caloangelo/NG-MEDIUM_NX1H35AS_KiCad_repo/PCB_Project.kicad_pcb

## KiCad design PCB_Project.kicad_pcb (2026-10-07)

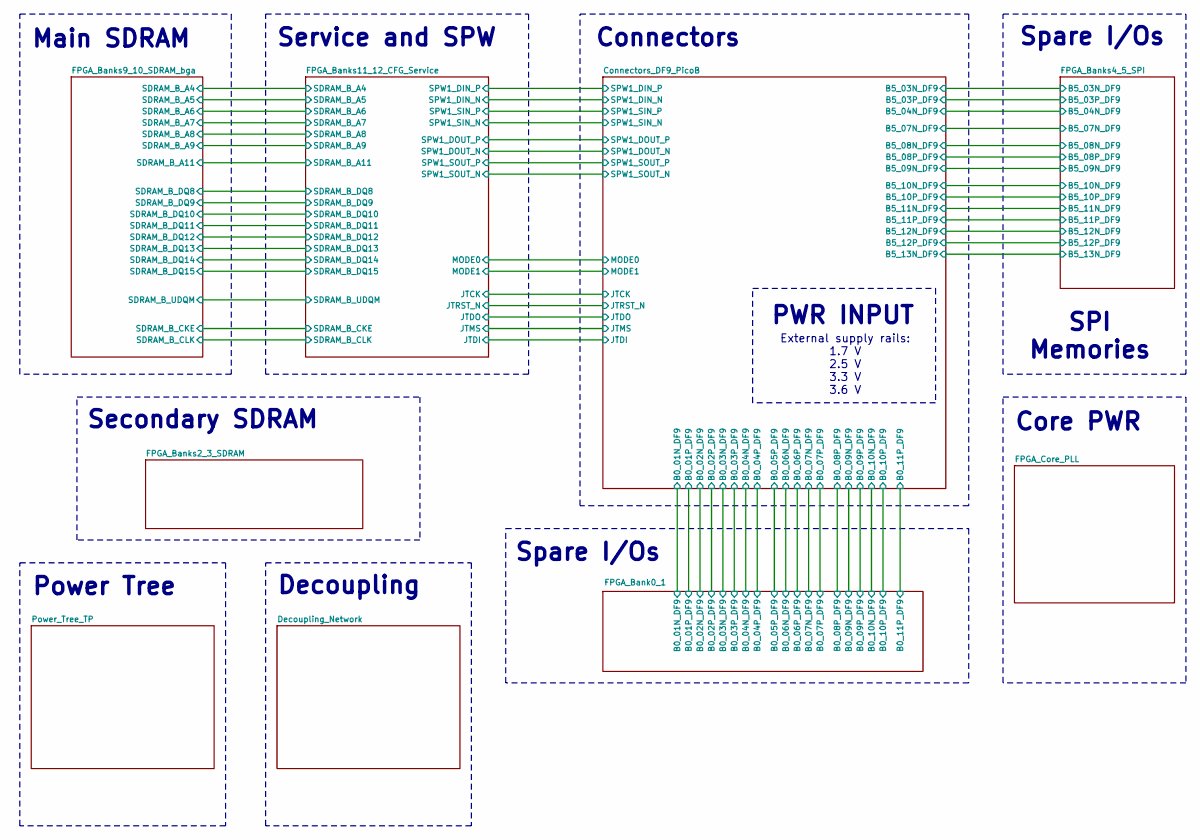
[picture p1: schematic PCB_Project.kicad_sch, DataHub+ Top-Level Schematic]

Notes on the sheet:
Spare I/Os
SPI Memories
Secondary SDRAM
Power Tree
Main SDRAM
Service and SPW
PWR INPUT
Decoupling
External supply rails: 1.7 V 2.5 V 3.3 V 3.6 V
Core PWR
Connectors

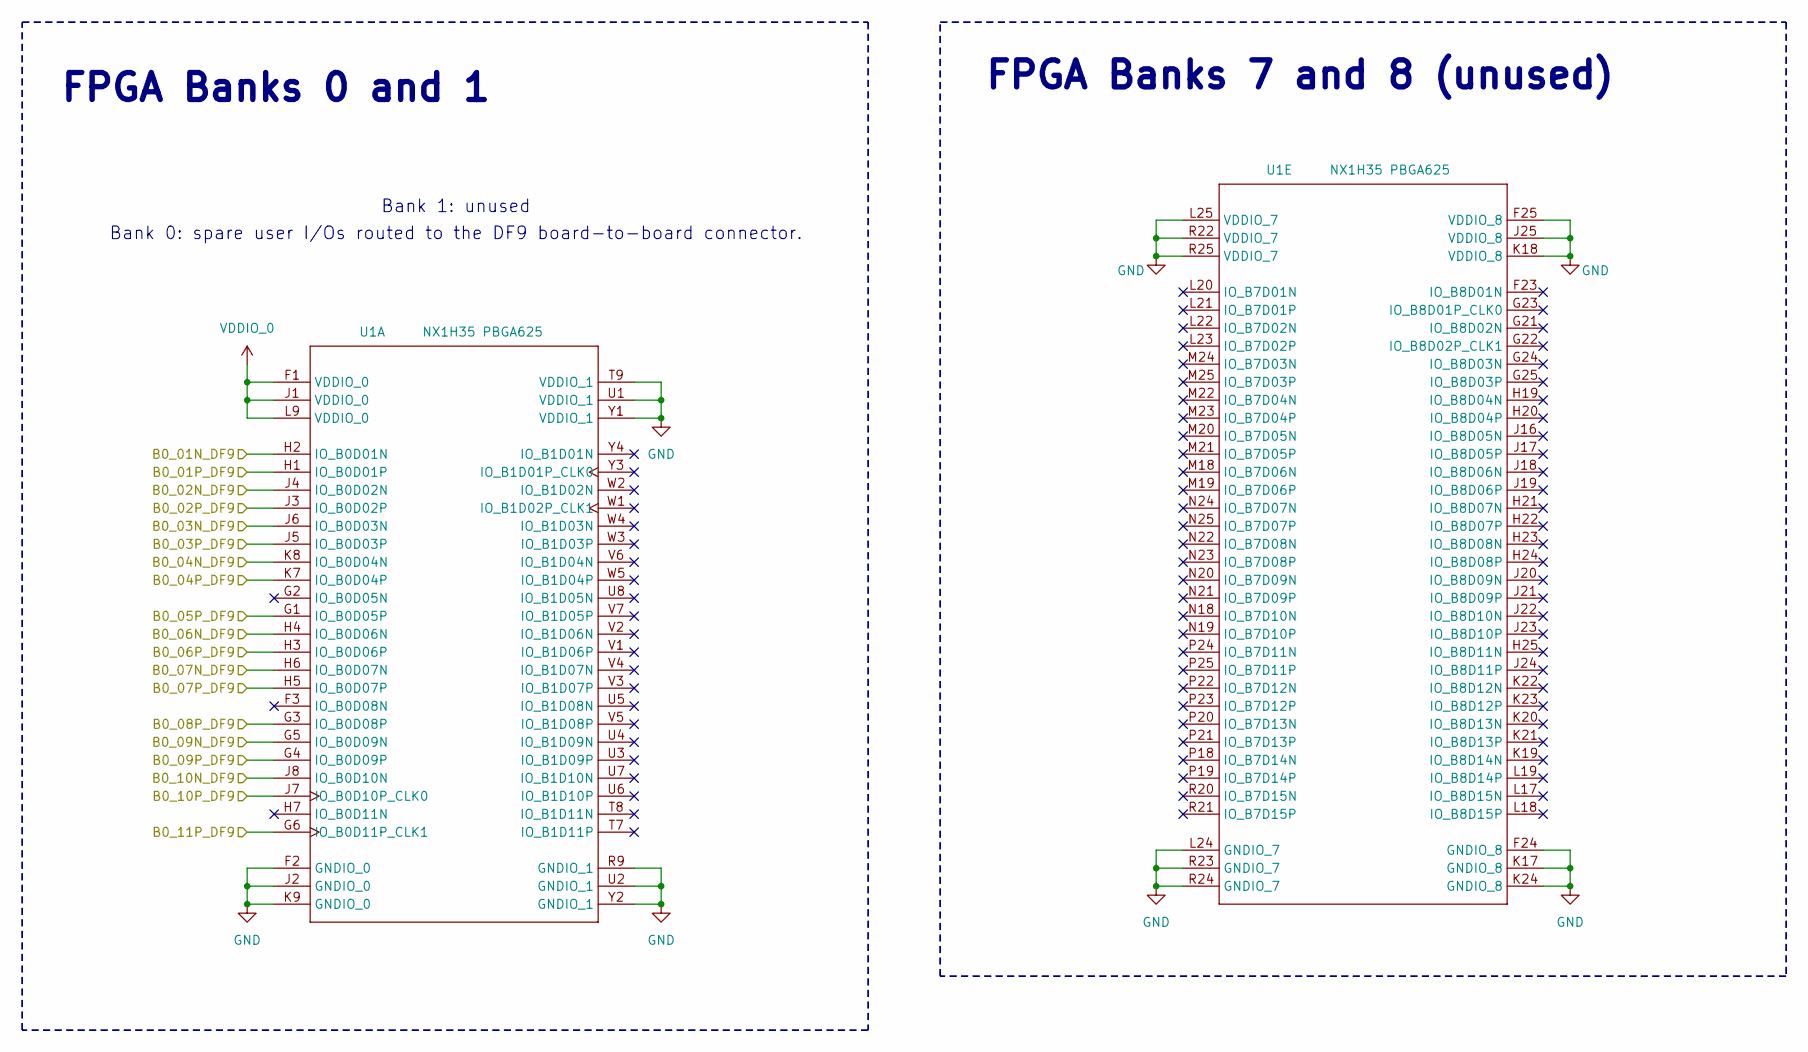
[picture p2: schematic FPGA_Bank0_1.kicad_sch, FPGA Banks 0 and 1]

Parts:
U1: NX1H35 PBGA625; NX1H35S_CLGA625

Connections:
/Connectors_DF9_PicoB/B0_01N_DF9: U1.H2 (IO_B0D01N); also elsewhere on the board
/Connectors_DF9_PicoB/B0_01P_DF9: U1.H1 (IO_B0D01P); also elsewhere on the board
/Connectors_DF9_PicoB/B0_02N_DF9: U1.J4 (IO_B0D02N); also elsewhere on the board
/Connectors_DF9_PicoB/B0_02P_DF9: U1.J3 (IO_B0D02P); also elsewhere on the board
/Connectors_DF9_PicoB/B0_03N_DF9: U1.J6 (IO_B0D03N); also elsewhere on the board
/Connectors_DF9_PicoB/B0_03P_DF9: U1.J5 (IO_B0D03P); also elsewhere on the board
/Connectors_DF9_PicoB/B0_04N_DF9: U1.K8 (IO_B0D04N); also elsewhere on the board
/Connectors_DF9_PicoB/B0_04P_DF9: U1.K7 (IO_B0D04P); also elsewhere on the board
/Connectors_DF9_PicoB/B0_05P_DF9: U1.G1 (IO_B0D05P); also elsewhere on the board
/Connectors_DF9_PicoB/B0_06N_DF9: U1.H4 (IO_B0D06N); also elsewhere on the board
/Connectors_DF9_PicoB/B0_06P_DF9: U1.H3 (IO_B0D06P); also elsewhere on the board
/Connectors_DF9_PicoB/B0_07N_DF9: U1.H6 (IO_B0D07N); also elsewhere on the board
/Connectors_DF9_PicoB/B0_07P_DF9: U1.H5 (IO_B0D07P); also elsewhere on the board
/Connectors_DF9_PicoB/B0_08P_DF9: U1.G3 (IO_B0D08P); also elsewhere on the board
/Connectors_DF9_PicoB/B0_09N_DF9: U1.G5 (IO_B0D09N); also elsewhere on the board
/Connectors_DF9_PicoB/B0_09P_DF9: U1.G4 (IO_B0D09P); also elsewhere on the board
/Connectors_DF9_PicoB/B0_10N_DF9: U1.J8 (IO_B0D10N); also elsewhere on the board
/Connectors_DF9_PicoB/B0_10P_DF9: U1.J7 (IO_B0D10P_CLK0); also elsewhere on the board
/Connectors_DF9_PicoB/B0_11P_DF9: U1.G6 (IO_B0D11P_CLK1); also elsewhere on the board
GND: U1.F2 (GNDIO_0), U1.F24 (GNDIO_8), U1.F25 (VDDIO_8), U1.J2 (GNDIO_0), U1.J25 (VDDIO_8), U1.K9 (GNDIO_0), U1.K17 (GNDIO_8), U1.K18 (VDDIO_8), U1.K24 (GNDIO_8), U1.L24 (GNDIO_7), U1.L25 (VDDIO_7), U1.R9 (GNDIO_1), U1.R22 (VDDIO_7), U1.R23 (GNDIO_7), U1.R24 (GNDIO_7), U1.R25 (VDDIO_7), U1.T9 (VDDIO_1), U1.U1 (VDDIO_1), U1.U2 (GNDIO_1), U1.Y1 (VDDIO_1), U1.Y2 (GNDIO_1); also elsewhere on the board
VDD3V3: U1.F1 (VDDIO_0), U1.J1 (VDDIO_0), U1.L9 (VDDIO_0); also elsewhere on the board

Notes on the sheet:
Bank 0: spare user I/Os routed to the DF9 board-to-board connector.
FPGA Banks 0 and 1
FPGA Banks 7 and 8 (unused)
Bank 1: unused

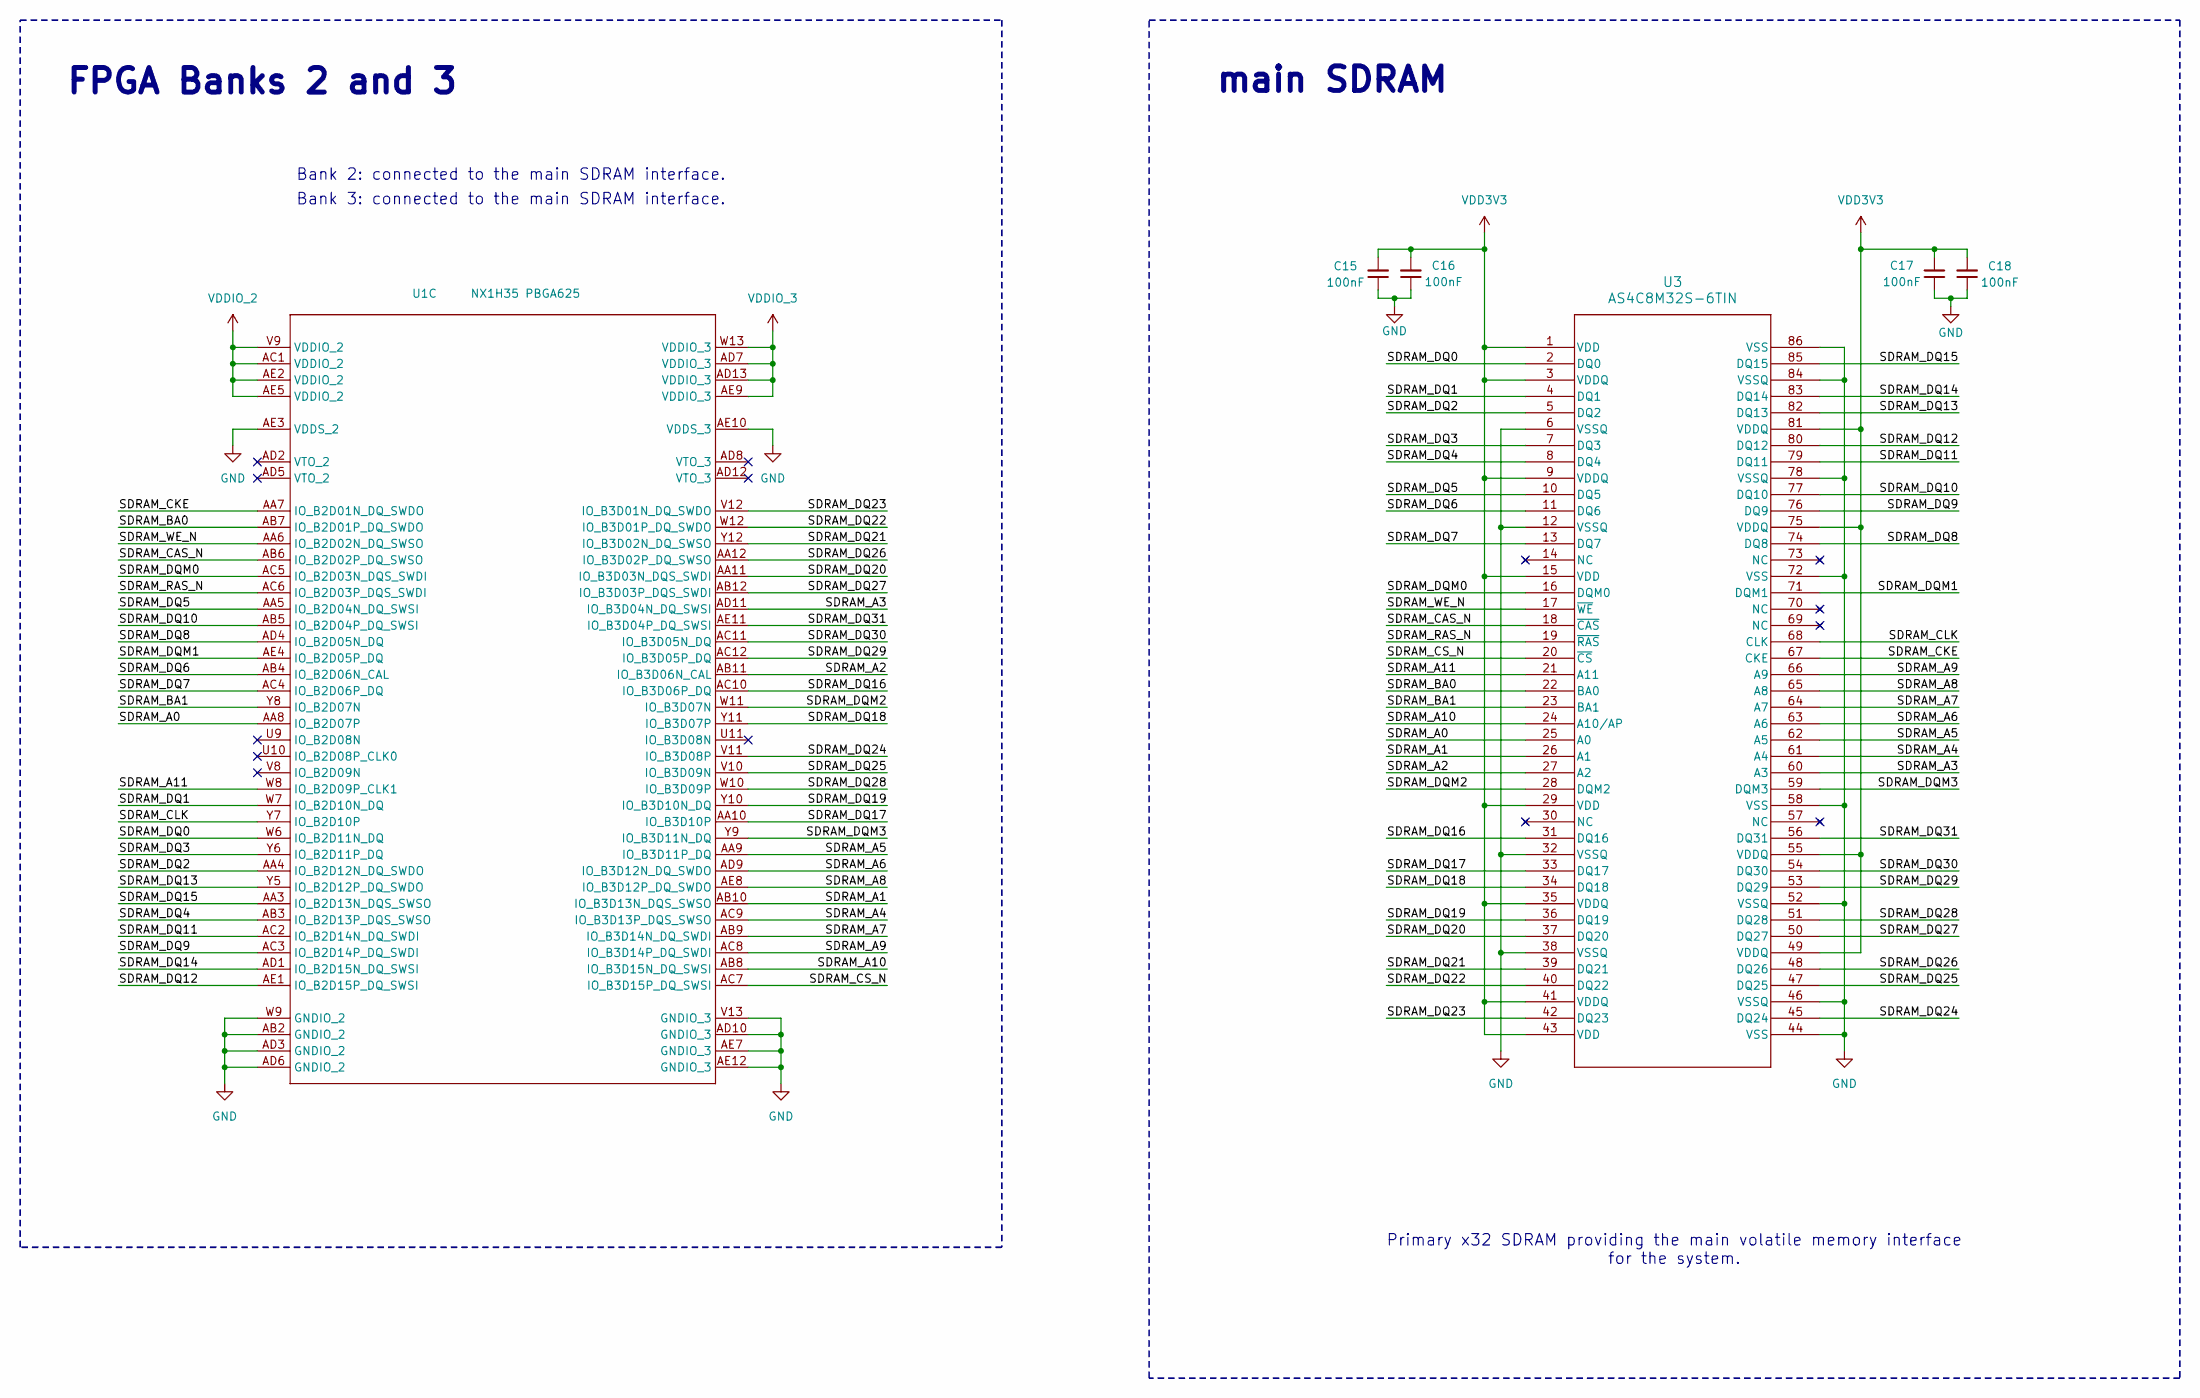
[picture p3: schematic FPGA_Banks2_3_SDRAM.kicad_sch, Primary SDRAM Interface - FPGA Banks 2 and 3]

Parts:
C15, C16, C17, C18: 100nF; C_0402_1005Metric_Pad0.74x0.62mm_HandSolder
U1: NX1H35 PBGA625; NX1H35S_CLGA625
U3: AS4C8M32S-6TIN; AS4C8M32S_TSOP-II-86_ALL

Connections:
/FPGA_Banks2_3_SDRAM/SDRAM_A0: U1.AA8 (IO_B2D07P), U3.25 (A0)
/FPGA_Banks2_3_SDRAM/SDRAM_A1: U1.AB10 (IO_B3D13N_DQS_SWSO), U3.26 (A1)
/FPGA_Banks2_3_SDRAM/SDRAM_A2: U1.AB11 (IO_B3D06N_CAL), U3.27 (A2)
/FPGA_Banks2_3_SDRAM/SDRAM_A3: U1.AD11 (IO_B3D04N_DQ_SWSI), U3.60 (A3)
/FPGA_Banks2_3_SDRAM/SDRAM_A4: U1.AC9 (IO_B3D13P_DQS_SWSO), U3.61 (A4)
/FPGA_Banks2_3_SDRAM/SDRAM_A5: U1.AA9 (IO_B3D11P_DQ), U3.62 (A5)
/FPGA_Banks2_3_SDRAM/SDRAM_A6: U1.AD9 (IO_B3D12N_DQ_SWDO), U3.63 (A6)
/FPGA_Banks2_3_SDRAM/SDRAM_A7: U1.AB9 (IO_B3D14N_DQ_SWDI), U3.64 (A7)
/FPGA_Banks2_3_SDRAM/SDRAM_A8: U1.AE8 (IO_B3D12P_DQ_SWDO), U3.65 (A8)
/FPGA_Banks2_3_SDRAM/SDRAM_A9: U1.AC8 (IO_B3D14P_DQ_SWDI), U3.66 (A9)
/FPGA_Banks2_3_SDRAM/SDRAM_A10: U1.AB8 (IO_B3D15N_DQ_SWSI), U3.24 (A10/AP)
/FPGA_Banks2_3_SDRAM/SDRAM_A11: U1.W8 (IO_B2D09P_CLK1), U3.21 (A11)
/FPGA_Banks2_3_SDRAM/SDRAM_BA0: U1.AB7 (IO_B2D01P_DQ_SWDO), U3.22 (BA0)
/FPGA_Banks2_3_SDRAM/SDRAM_BA1: U1.Y8 (IO_B2D07N), U3.23 (BA1)
/FPGA_Banks2_3_SDRAM/SDRAM_CAS_N: U1.AB6 (IO_B2D02P_DQ_SWSO), U3.18 (~CAS)
/FPGA_Banks2_3_SDRAM/SDRAM_CKE: U1.AA7 (IO_B2D01N_DQ_SWDO), U3.67 (CKE)
/FPGA_Banks2_3_SDRAM/SDRAM_CLK: U1.Y7 (IO_B2D10P), U3.68 (CLK)
/FPGA_Banks2_3_SDRAM/SDRAM_CS_N: U1.AC7 (IO_B3D15P_DQ_SWSI), U3.20 (~CS)
/FPGA_Banks2_3_SDRAM/SDRAM_DQ0: U1.W6 (IO_B2D11N_DQ), U3.2 (DQ0)
/FPGA_Banks2_3_SDRAM/SDRAM_DQ1: U1.W7 (IO_B2D10N_DQ), U3.4 (DQ1)
/FPGA_Banks2_3_SDRAM/SDRAM_DQ2: U1.AA4 (IO_B2D12N_DQ_SWDO), U3.5 (DQ2)
/FPGA_Banks2_3_SDRAM/SDRAM_DQ3: U1.Y6 (IO_B2D11P_DQ), U3.7 (DQ3)
/FPGA_Banks2_3_SDRAM/SDRAM_DQ4: U1.AB3 (IO_B2D13P_DQS_SWSO), U3.8 (DQ4)
/FPGA_Banks2_3_SDRAM/SDRAM_DQ5: U1.AA5 (IO_B2D04N_DQ_SWSI), U3.10 (DQ5)
/FPGA_Banks2_3_SDRAM/SDRAM_DQ6: U1.AB4 (IO_B2D06N_CAL), U3.11 (DQ6)
/FPGA_Banks2_3_SDRAM/SDRAM_DQ7: U1.AC4 (IO_B2D06P_DQ), U3.13 (DQ7)
/FPGA_Banks2_3_SDRAM/SDRAM_DQ8: U1.AD4 (IO_B2D05N_DQ), U3.74 (DQ8)
/FPGA_Banks2_3_SDRAM/SDRAM_DQ9: U1.AC3 (IO_B2D14P_DQ_SWDI), U3.76 (DQ9)
/FPGA_Banks2_3_SDRAM/SDRAM_DQ10: U1.AB5 (IO_B2D04P_DQ_SWSI), U3.77 (DQ10)
/FPGA_Banks2_3_SDRAM/SDRAM_DQ11: U1.AC2 (IO_B2D14N_DQ_SWDI), U3.79 (DQ11)
/FPGA_Banks2_3_SDRAM/SDRAM_DQ12: U1.AE1 (IO_B2D15P_DQ_SWSI), U3.80 (DQ12)
/FPGA_Banks2_3_SDRAM/SDRAM_DQ13: U1.Y5 (IO_B2D12P_DQ_SWDO), U3.82 (DQ13)
/FPGA_Banks2_3_SDRAM/SDRAM_DQ14: U1.AD1 (IO_B2D15N_DQ_SWSI), U3.83 (DQ14)
/FPGA_Banks2_3_SDRAM/SDRAM_DQ15: U1.AA3 (IO_B2D13N_DQS_SWSO), U3.85 (DQ15)
/FPGA_Banks2_3_SDRAM/SDRAM_DQ16: U1.AC10 (IO_B3D06P_DQ), U3.31 (DQ16)
/FPGA_Banks2_3_SDRAM/SDRAM_DQ17: U1.AA10 (IO_B3D10P), U3.33 (DQ17)
/FPGA_Banks2_3_SDRAM/SDRAM_DQ18: U1.Y11 (IO_B3D07P), U3.34 (DQ18)
/FPGA_Banks2_3_SDRAM/SDRAM_DQ19: U1.Y10 (IO_B3D10N_DQ), U3.36 (DQ19)
/FPGA_Banks2_3_SDRAM/SDRAM_DQ20: U1.AA11 (IO_B3D03N_DQS_SWDI), U3.37 (DQ20)
/FPGA_Banks2_3_SDRAM/SDRAM_DQ21: U1.Y12 (IO_B3D02N_DQ_SWSO), U3.39 (DQ21)
/FPGA_Banks2_3_SDRAM/SDRAM_DQ22: U1.W12 (IO_B3D01P_DQ_SWDO), U3.40 (DQ22)
/FPGA_Banks2_3_SDRAM/SDRAM_DQ23: U1.V12 (IO_B3D01N_DQ_SWDO), U3.42 (DQ23)
/FPGA_Banks2_3_SDRAM/SDRAM_DQ24: U1.V11 (IO_B3D08P), U3.45 (DQ24)
/FPGA_Banks2_3_SDRAM/SDRAM_DQ25: U1.V10 (IO_B3D09N), U3.47 (DQ25)
/FPGA_Banks2_3_SDRAM/SDRAM_DQ26: U1.AA12 (IO_B3D02P_DQ_SWSO), U3.48 (DQ26)
/FPGA_Banks2_3_SDRAM/SDRAM_DQ27: U1.AB12 (IO_B3D03P_DQS_SWDI), U3.50 (DQ27)
/FPGA_Banks2_3_SDRAM/SDRAM_DQ28: U1.W10 (IO_B3D09P), U3.51 (DQ28)
/FPGA_Banks2_3_SDRAM/SDRAM_DQ29: U1.AC12 (IO_B3D05P_DQ), U3.53 (DQ29)
/FPGA_Banks2_3_SDRAM/SDRAM_DQ30: U1.AC11 (IO_B3D05N_DQ), U3.54 (DQ30)
/FPGA_Banks2_3_SDRAM/SDRAM_DQ31: U1.AE11 (IO_B3D04P_DQ_SWSI), U3.56 (DQ31)
/FPGA_Banks2_3_SDRAM/SDRAM_DQM0: U1.AC5 (IO_B2D03N_DQS_SWDI), U3.16 (DQM0)
/FPGA_Banks2_3_SDRAM/SDRAM_DQM1: U1.AE4 (IO_B2D05P_DQ), U3.71 (DQM1)
/FPGA_Banks2_3_SDRAM/SDRAM_DQM2: U1.W11 (IO_B3D07N), U3.28 (DQM2)
/FPGA_Banks2_3_SDRAM/SDRAM_DQM3: U1.Y9 (IO_B3D11N_DQ), U3.59 (DQM3)
/FPGA_Banks2_3_SDRAM/SDRAM_RAS_N: U1.AC6 (IO_B2D03P_DQS_SWDI), U3.19 (~RAS)
/FPGA_Banks2_3_SDRAM/SDRAM_WE_N: U1.AA6 (IO_B2D02N_DQ_SWSO), U3.17 (~WE)
GND: C15.1, C16.1, C17.1, C18.1, U1.AB2 (GNDIO_2), U1.AD3 (GNDIO_2), U1.AD6 (GNDIO_2), U1.AD10 (GNDIO_3), U1.AE3 (VDDS_2), U1.AE7 (GNDIO_3), U1.AE10 (VDDS_3), U1.AE12 (GNDIO_3), U1.V13 (GNDIO_3), U1.W9 (GNDIO_2), U3.6 (VSSQ), U3.12 (VSSQ), U3.32 (VSSQ), U3.38 (VSSQ), U3.44 (VSS), U3.46 (VSSQ), U3.52 (VSSQ), U3.58 (VSS), U3.72 (VSS), U3.78 (VSSQ), U3.84 (VSSQ), U3.86 (VSS); also elsewhere on the board
VDD3V3: C15.2, C16.2, C17.2, C18.2, U1.AC1 (VDDIO_2), U1.AD7 (VDDIO_3), U1.AD13 (VDDIO_3), U1.AE2 (VDDIO_2), U1.AE5 (VDDIO_2), U1.AE9 (VDDIO_3), U1.V9 (VDDIO_2), U1.W13 (VDDIO_3), U3.1 (VDD), U3.3 (VDDQ), U3.9 (VDDQ), U3.15 (VDD), U3.29 (VDD), U3.35 (VDDQ), U3.41 (VDDQ), U3.43 (VDD), U3.49 (VDDQ), U3.55 (VDDQ), U3.75 (VDDQ), U3.81 (VDDQ); also elsewhere on the board

Notes on the sheet:
Bank 3: connected to the main SDRAM interface.
main SDRAM
FPGA Banks 2 and 3
Primary x32 SDRAM providing the main volatile memory interface for the system.
Bank 2: connected to the main SDRAM interface.

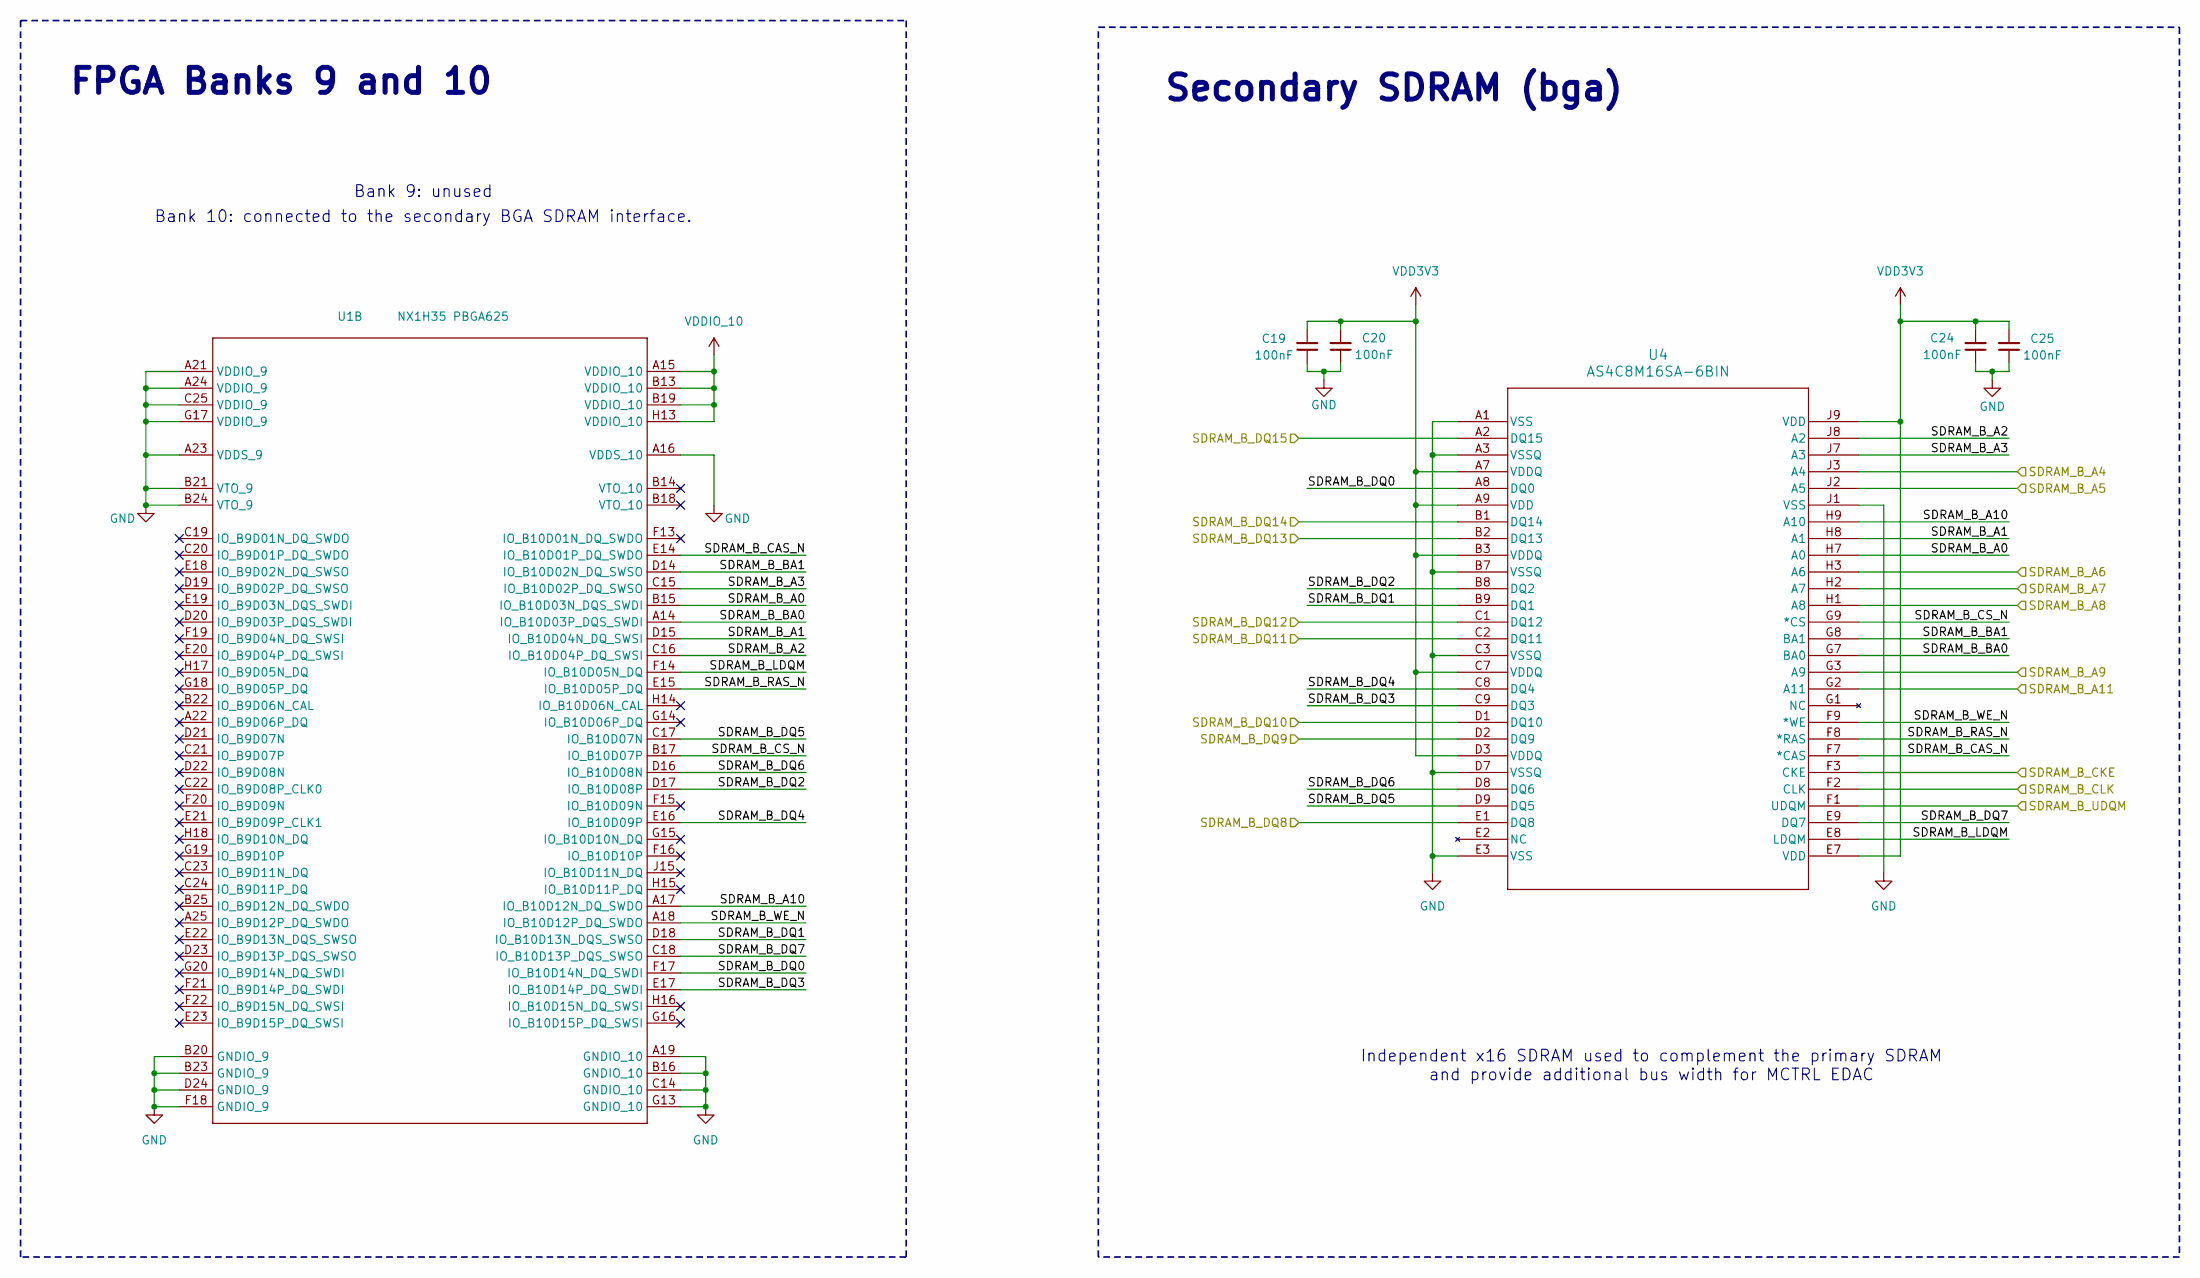
[picture p4: schematic FPGA_Banks9_10_SDRAM_bga.kicad_sch, Secondary SDRAM Interface - FPGA Banks 9 and 10]

Parts:
C19, C20, C24, C25: 100nF; C_0402_1005Metric_Pad0.74x0.62mm_HandSolder
U1: NX1H35 PBGA625; NX1H35S_CLGA625
U4: AS4C8M16SA-6BIN; sdram2_bga_TFBGA-54_8X8_ALL

Connections:
/FPGA_Banks9_10_SDRAM_bga/SDRAM_B_A0: U1.B15 (IO_B10D03N_DQS_SWDI), U4.H7 (A0)
/FPGA_Banks9_10_SDRAM_bga/SDRAM_B_A1: U1.D15 (IO_B10D04N_DQ_SWSI), U4.H8 (A1)
/FPGA_Banks9_10_SDRAM_bga/SDRAM_B_A2: U1.C16 (IO_B10D04P_DQ_SWSI), U4.J8 (A2)
/FPGA_Banks9_10_SDRAM_bga/SDRAM_B_A3: U1.C15 (IO_B10D02P_DQ_SWSO), U4.J7 (A3)
/FPGA_Banks9_10_SDRAM_bga/SDRAM_B_A10: U1.A17 (IO_B10D12N_DQ_SWDO), U4.H9 (A10)
/FPGA_Banks9_10_SDRAM_bga/SDRAM_B_BA0: U1.A14 (IO_B10D03P_DQS_SWDI), U4.G7 (BA0)
/FPGA_Banks9_10_SDRAM_bga/SDRAM_B_BA1: U1.D14 (IO_B10D02N_DQ_SWSO), U4.G8 (BA1)
/FPGA_Banks9_10_SDRAM_bga/SDRAM_B_CAS_N: U1.E14 (IO_B10D01P_DQ_SWDO), U4.F7 (*CAS)
/FPGA_Banks9_10_SDRAM_bga/SDRAM_B_CS_N: U1.B17 (IO_B10D07P), U4.G9 (*CS)
/FPGA_Banks9_10_SDRAM_bga/SDRAM_B_DQ0: U1.F17 (IO_B10D14N_DQ_SWDI), U4.A8 (DQ0)
/FPGA_Banks9_10_SDRAM_bga/SDRAM_B_DQ1: U1.D18 (IO_B10D13N_DQS_SWSO), U4.B9 (DQ1)
/FPGA_Banks9_10_SDRAM_bga/SDRAM_B_DQ2: U1.D17 (IO_B10D08P), U4.B8 (DQ2)
/FPGA_Banks9_10_SDRAM_bga/SDRAM_B_DQ3: U1.E17 (IO_B10D14P_DQ_SWDI), U4.C9 (DQ3)
/FPGA_Banks9_10_SDRAM_bga/SDRAM_B_DQ4: U1.E16 (IO_B10D09P), U4.C8 (DQ4)
/FPGA_Banks9_10_SDRAM_bga/SDRAM_B_DQ5: U1.C17 (IO_B10D07N), U4.D9 (DQ5)
/FPGA_Banks9_10_SDRAM_bga/SDRAM_B_DQ6: U1.D16 (IO_B10D08N), U4.D8 (DQ6)
/FPGA_Banks9_10_SDRAM_bga/SDRAM_B_DQ7: U1.C18 (IO_B10D13P_DQS_SWSO), U4.E9 (DQ7)
/FPGA_Banks9_10_SDRAM_bga/SDRAM_B_LDQM: U1.F14 (IO_B10D05N_DQ), U4.E8 (LDQM)
/FPGA_Banks9_10_SDRAM_bga/SDRAM_B_RAS_N: U1.E15 (IO_B10D05P_DQ), U4.F8 (*RAS)
/FPGA_Banks9_10_SDRAM_bga/SDRAM_B_WE_N: U1.A18 (IO_B10D12P_DQ_SWDO), U4.F9 (*WE)
/FPGA_Banks11_12_CFG_Service/SDRAM_B_A4: U4.J3 (A4); also elsewhere on the board
/FPGA_Banks11_12_CFG_Service/SDRAM_B_A5: U4.J2 (A5); also elsewhere on the board
/FPGA_Banks11_12_CFG_Service/SDRAM_B_A6: U4.H3 (A6); also elsewhere on the board
/FPGA_Banks11_12_CFG_Service/SDRAM_B_A7: U4.H2 (A7); also elsewhere on the board
/FPGA_Banks11_12_CFG_Service/SDRAM_B_A8: U4.H1 (A8); also elsewhere on the board
/FPGA_Banks11_12_CFG_Service/SDRAM_B_A9: U4.G3 (A9); also elsewhere on the board
/FPGA_Banks11_12_CFG_Service/SDRAM_B_A11: U4.G2 (A11); also elsewhere on the board
/FPGA_Banks11_12_CFG_Service/SDRAM_B_CKE: U4.F3 (CKE); also elsewhere on the board
/FPGA_Banks11_12_CFG_Service/SDRAM_B_CLK: U4.F2 (CLK); also elsewhere on the board
/FPGA_Banks11_12_CFG_Service/SDRAM_B_DQ8: U4.E1 (DQ8); also elsewhere on the board
/FPGA_Banks11_12_CFG_Service/SDRAM_B_DQ9: U4.D2 (DQ9); also elsewhere on the board
/FPGA_Banks11_12_CFG_Service/SDRAM_B_DQ10: U4.D1 (DQ10); also elsewhere on the board
/FPGA_Banks11_12_CFG_Service/SDRAM_B_DQ11: U4.C2 (DQ11); also elsewhere on the board
/FPGA_Banks11_12_CFG_Service/SDRAM_B_DQ12: U4.C1 (DQ12); also elsewhere on the board
/FPGA_Banks11_12_CFG_Service/SDRAM_B_DQ13: U4.B2 (DQ13); also elsewhere on the board
/FPGA_Banks11_12_CFG_Service/SDRAM_B_DQ14: U4.B1 (DQ14); also elsewhere on the board
/FPGA_Banks11_12_CFG_Service/SDRAM_B_DQ15: U4.A2 (DQ15); also elsewhere on the board
/FPGA_Banks11_12_CFG_Service/SDRAM_B_UDQM: U4.F1 (UDQM); also elsewhere on the board
GND: C19.1, C20.1, C24.1, C25.1, U1.A16 (VDDS_10), U1.A19 (GNDIO_10), U1.A21 (VDDIO_9), U1.A23 (VDDS_9), U1.A24 (VDDIO_9), U1.B16 (GNDIO_10), U1.B20 (GNDIO_9), U1.B21 (VTO_9), U1.B23 (GNDIO_9), U1.B24 (VTO_9), U1.C14 (GNDIO_10), U1.C25 (VDDIO_9), U1.D24 (GNDIO_9), U1.F18 (GNDIO_9), U1.G13 (GNDIO_10), U1.G17 (VDDIO_9), U4.A1 (VSS), U4.A3 (VSSQ), U4.B7 (VSSQ), U4.C3 (VSSQ), U4.D7 (VSSQ), U4.E3 (VSS), U4.J1 (VSS); also elsewhere on the board
VDD3V3: C19.2, C20.2, C24.2, C25.2, U1.A15 (VDDIO_10), U1.B13 (VDDIO_10), U1.B19 (VDDIO_10), U1.H13 (VDDIO_10), U4.A7 (VDDQ), U4.A9 (VDD), U4.B3 (VDDQ), U4.C7 (VDDQ), U4.D3 (VDDQ), U4.E7 (VDD), U4.J9 (VDD); also elsewhere on the board

Notes on the sheet:
Bank 9: unused
FPGA Banks 9 and 10
Secondary SDRAM (bga)
Independent x16 SDRAM used to complement the primary SDRAM and provide additional bus width for MCTRL EDAC
Bank 10: connected to the secondary BGA SDRAM interface.

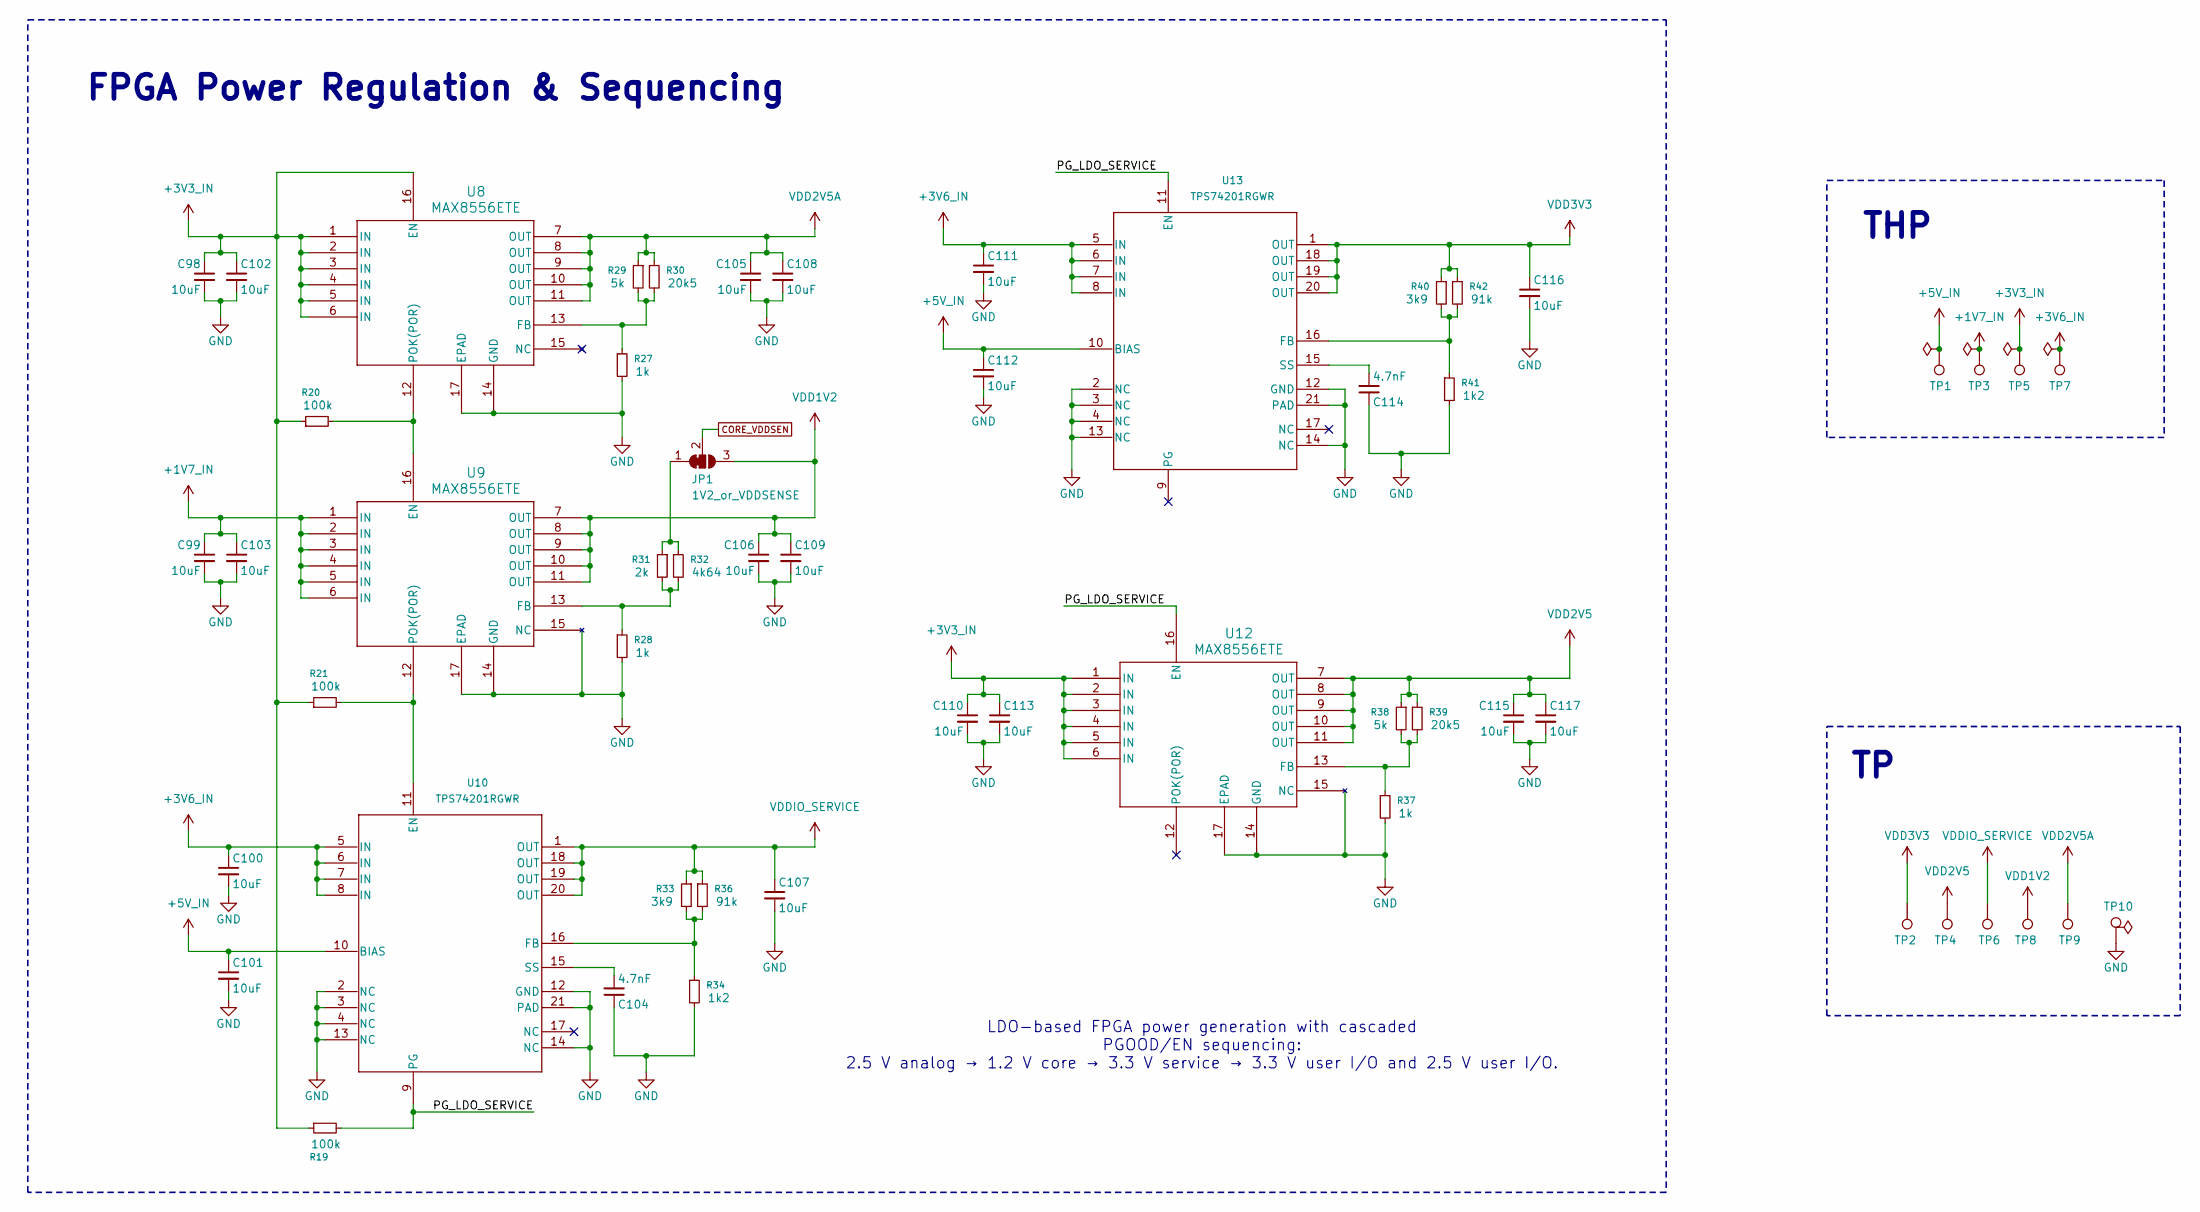
[picture p5: schematic Power_Tree_TP.kicad_sch, Power Tree and Test Points]

Parts:
C98, C99, C100, C101, C102, C103, C105, C106, C107, C108, C109, C110, C111, C112, C113, C115, C116, C117: 10uF; C_0603_1608Metric_Pad1.08x0.95mm_HandSolder
C104, C114: 4.7nF; C_0402_1005Metric_Pad0.74x0.62mm_HandSolder
JP1: 1V2_or_VDDSENSE; SolderJumper-3_P1.3mm_Bridged2Bar12_RoundedPad1.0x1.5mm
R19, R20, R21: 100k; R_0402_1005Metric_Pad0.72x0.64mm_HandSolder
R27, R28, R37: 1k; R_0402_1005Metric_Pad0.72x0.64mm_HandSolder
R29, R38: 5k; R_0402_1005Metric_Pad0.72x0.64mm_HandSolder
R30, R39: 20k5; R_0402_1005Metric_Pad0.72x0.64mm_HandSolder
R31: 2k; R_0402_1005Metric_Pad0.72x0.64mm_HandSolder
R32: 4k64; R_0402_1005Metric_Pad0.72x0.64mm_HandSolder
R33, R40: 3k9; R_0402_1005Metric_Pad0.72x0.64mm_HandSolder
R34, R41: 1k2; R_0402_1005Metric_Pad0.72x0.64mm_HandSolder
R36, R42: 91k; R_0402_1005Metric_Pad0.72x0.64mm_HandSolder
TP1: 5V; PTH_pad_2x0.8
TP2, TP6: 3V3; Test_Point
TP3: 1V7; PTH_pad_2x0.8
TP4: 2V5; Test_Point
TP5: 3V3; PTH_pad_2x0.8
TP7: 3V6; PTH_pad_2x0.8
TP8: 1V2; Test_Point
TP9: 2V5A; Test_Point
TP10: GND; Test_Point
U8, U9, U12: MAX8556ETE; MAX8556
U10, U13: TPS74201RGWR; TPS74201

Connections:
+1V7_IN: C99.1, C103.1, TP3.1, U9.1 (IN), U9.2 (IN), U9.3 (IN), U9.4 (IN), U9.5 (IN), U9.6 (IN); also elsewhere on the board
+3V3_IN: C98.1, C102.1, C110.1, C113.1, R19.1, R20.1, R21.1, TP5.1, U8.1 (IN), U8.2 (IN), U8.3 (IN), U8.4 (IN), U8.5 (IN), U8.6 (IN), U8.16 (EN), U12.1 (IN), U12.2 (IN), U12.3 (IN), U12.4 (IN), U12.5 (IN), U12.6 (IN); also elsewhere on the board
+3V6_IN: C100.1, C111.1, TP7.1, U10.5 (IN), U10.6 (IN), U10.7 (IN), U10.8 (IN), U13.5 (IN), U13.6 (IN), U13.7 (IN), U13.8 (IN); also elsewhere on the board
+5V_IN: C101.1, C112.1, TP1.1, U10.10 (BIAS), U13.10 (BIAS); also elsewhere on the board
/Power_Tree_TP/PG_LDO_SERVICE: R19.2, U10.9 (PG), U12.16 (EN), U13.11 (EN)
CORE_VDDSEN: JP1.2 (C); also elsewhere on the board
GND: C98.2, C99.2, C100.2, C101.2, C102.2, C103.2, C104.1, C105.2, C106.2, C107.2, C108.2, C109.2, C110.2, C111.2, C112.2, C113.2, C114.1, C115.2, C116.2, C117.2, R27.2, R28.2, R34.2, R37.2, R41.2, TP10.1, U8.14 (GND), U8.17 (EPAD), U9.14 (GND), U9.15 (NC), U9.17 (EPAD), U10.2 (NC), U10.3 (NC), U10.4 (NC), U10.12 (GND), U10.13 (NC), U10.14 (NC), U10.21 (PAD), U12.14 (GND), U12.15 (NC), U12.17 (EPAD), U13.2 (NC), U13.3 (NC), U13.4 (NC), U13.12 (GND), U13.13 (NC), U13.14 (NC), U13.21 (PAD); also elsewhere on the board
unnamed: JP1.1 (A), R31.1, R32.1
unnamed: R27.1, R29.2, R30.2, U8.13 (FB)
unnamed: R20.2, U8.12 (POK(POR)), U9.16 (EN)
unnamed: R28.1, R31.2, R32.2, U9.13 (FB)
unnamed: R21.2, U9.12 (POK(POR)), U10.11 (EN)
unnamed: R33.2, R34.1, R36.2, U10.16 (FB)
unnamed: C104.2, U10.15 (SS)
unnamed: R37.1, R38.2, R39.2, U12.13 (FB)
unnamed: R40.2, R41.1, R42.2, U13.16 (FB)
unnamed: C114.2, U13.15 (SS)
VDD1V2: C106.1, C109.1, JP1.3 (B), TP8.1, U9.7 (OUT), U9.8 (OUT), U9.9 (OUT), U9.10 (OUT), U9.11 (OUT); also elsewhere on the board
VDD2V5: C115.1, C117.1, R38.1, R39.1, TP4.1, U12.7 (OUT), U12.8 (OUT), U12.9 (OUT), U12.10 (OUT), U12.11 (OUT); also elsewhere on the board
VDD2V5A: C105.1, C108.1, R29.1, R30.1, TP9.1, U8.7 (OUT), U8.8 (OUT), U8.9 (OUT), U8.10 (OUT), U8.11 (OUT); also elsewhere on the board
VDD3V3: C116.1, R40.1, R42.1, TP2.1, U13.1 (OUT), U13.18 (OUT), U13.19 (OUT), U13.20 (OUT); also elsewhere on the board
VDDIO_SERVICE: C107.1, R33.1, R36.1, TP6.1, U10.1 (OUT), U10.18 (OUT), U10.19 (OUT), U10.20 (OUT); also elsewhere on the board

Notes on the sheet:
LDO-based FPGA power generation with cascaded PGOOD/EN sequencing: 2.5 V analog → 1.2 V core → 3.3 V service → 3.3 V user I/O and 2.5 V user I/O.
THP
FPGA Power Regulation & Sequencing
