caloangelo/NG-MEDIUM_NX1H35AS_KiCad_repo/PCB_Project.kicad_pcb

## KiCad design PCB_Project.kicad_pcb (continued)

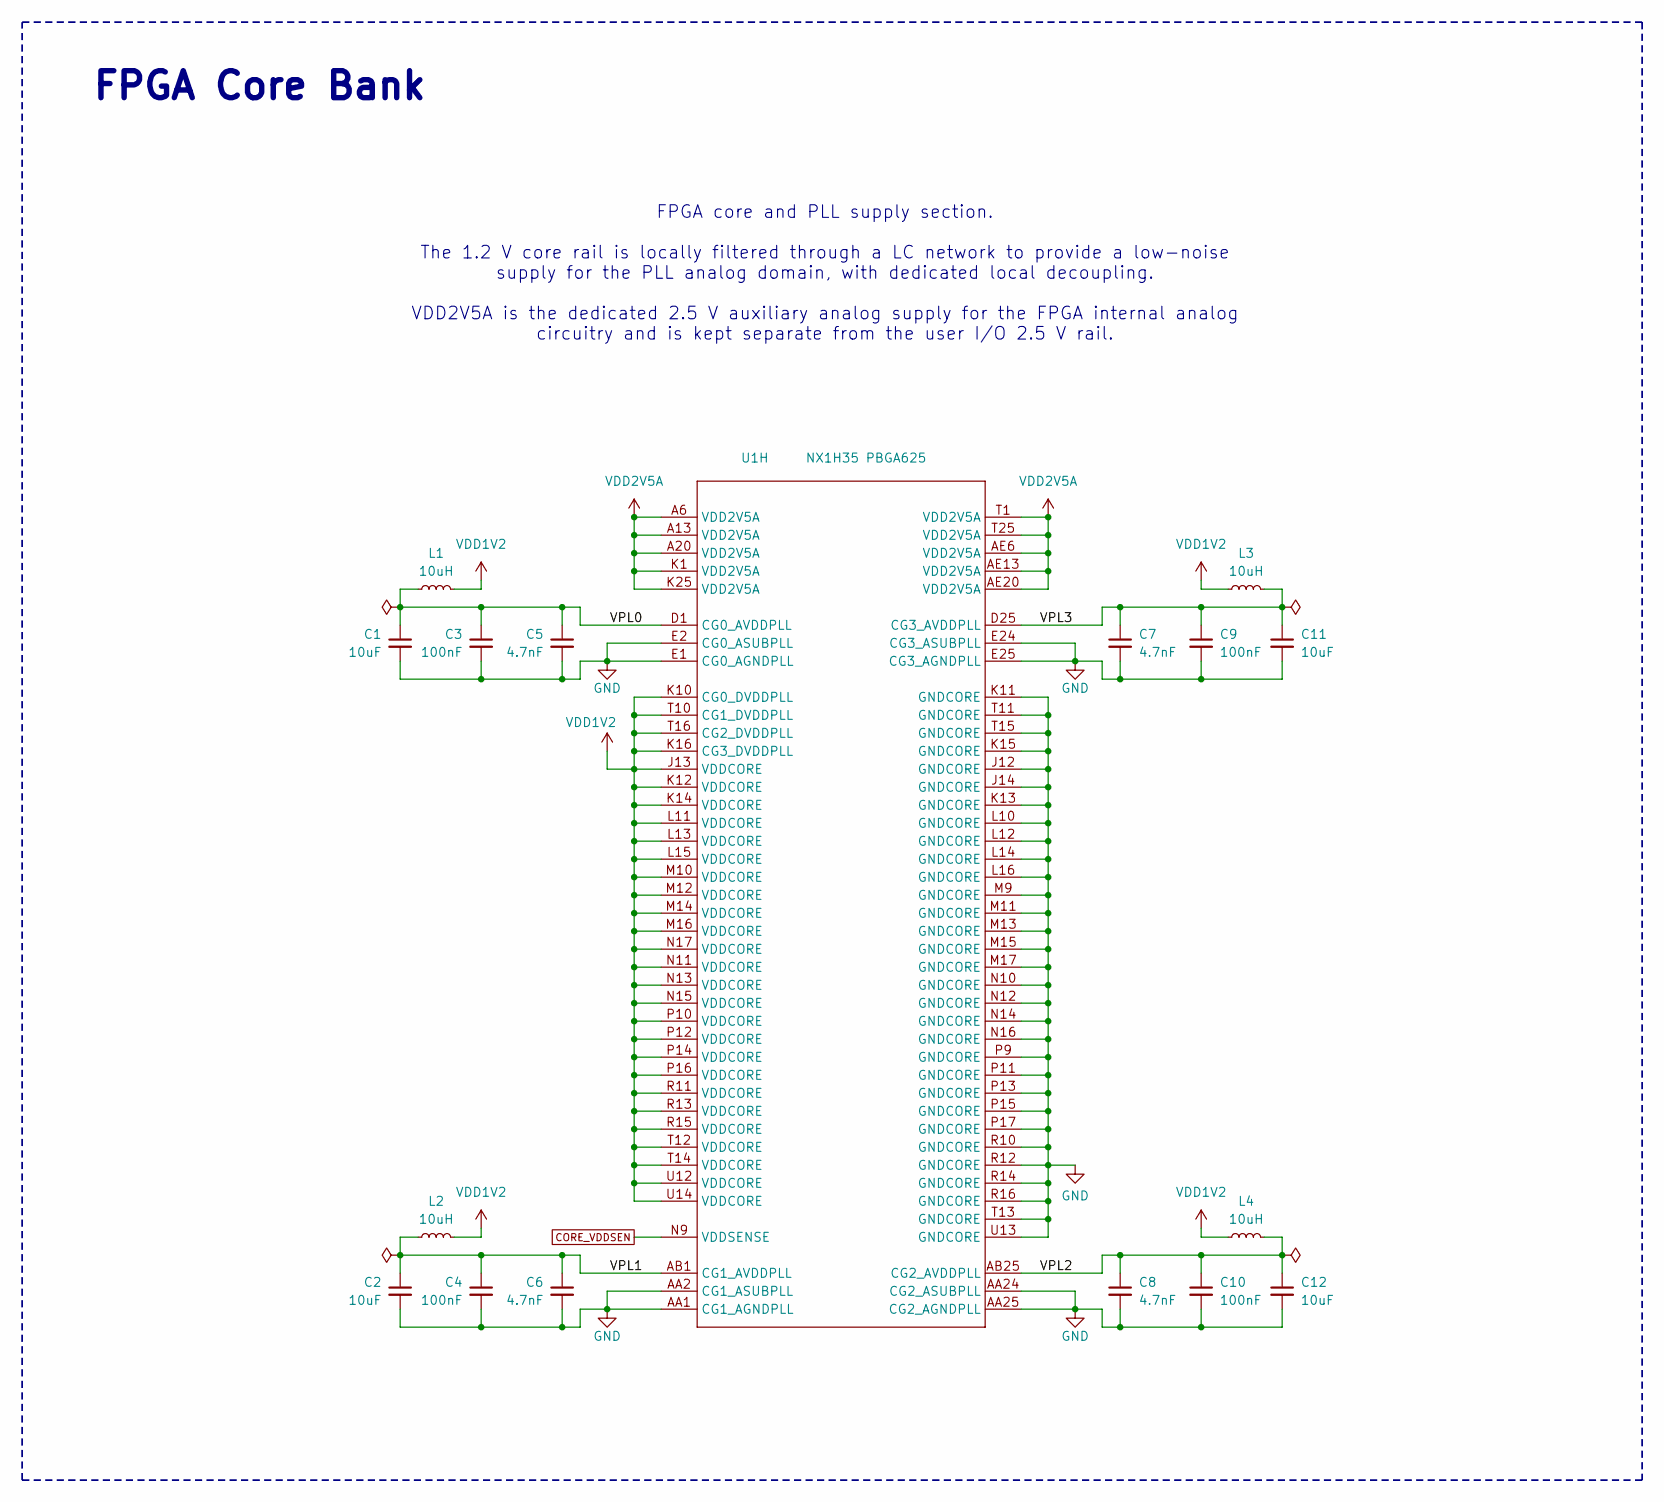
[picture p6: schematic FPGA_Core_PLL.kicad_sch, FPGA Core and PLL Supplies]

Parts:
C1, C2, C11, C12: 10uF; C_0603_1608Metric_Pad1.08x0.95mm_HandSolder
C3, C4, C9, C10: 100nF; C_0402_1005Metric_Pad0.74x0.62mm_HandSolder
C5, C6, C7, C8: 4.7nF; C_0402_1005Metric_Pad0.74x0.62mm_HandSolder
L1, L2, L3, L4: 10uH; L_0603_1608Metric_Pad1.05x0.95mm_HandSolder
U1: NX1H35 PBGA625; NX1H35S_CLGA625

Connections:
/FPGA_Core_PLL/VPL0: C1.1, C3.1, C5.1, L1.2, U1.D1 (CG0_AVDDPLL)
/FPGA_Core_PLL/VPL1: C2.1, C4.1, C6.1, L2.2, U1.AB1 (CG1_AVDDPLL)
/FPGA_Core_PLL/VPL2: C8.1, C10.1, C12.1, L4.2, U1.AB25 (CG2_AVDDPLL)
/FPGA_Core_PLL/VPL3: C7.1, C9.1, C11.1, L3.2, U1.D25 (CG3_AVDDPLL)
CORE_VDDSEN: U1.N9 (VDDSENSE); also elsewhere on the board
GND: C1.2, C2.2, C3.2, C4.2, C5.2, C6.2, C7.2, C8.2, C9.2, C10.2, C11.2, C12.2, U1.AA1 (CG1_AGNDPLL), U1.AA2 (CG1_ASUBPLL), U1.AA24 (CG2_ASUBPLL), U1.AA25 (CG2_AGNDPLL), U1.E1 (CG0_AGNDPLL), U1.E2 (CG0_ASUBPLL), U1.E24 (CG3_ASUBPLL), U1.E25 (CG3_AGNDPLL), U1.J12 (GNDCORE), U1.J14 (GNDCORE), U1.K11 (GNDCORE), U1.K13 (GNDCORE), U1.K15 (GNDCORE), U1.L10 (GNDCORE), U1.L12 (GNDCORE), U1.L14 (GNDCORE), U1.L16 (GNDCORE), U1.M9 (GNDCORE), U1.M11 (GNDCORE), U1.M13 (GNDCORE), U1.M15 (GNDCORE), U1.M17 (GNDCORE), U1.N10 (GNDCORE), U1.N12 (GNDCORE), U1.N14 (GNDCORE), U1.N16 (GNDCORE), U1.P9 (GNDCORE), U1.P11 (GNDCORE), U1.P13 (GNDCORE), U1.P15 (GNDCORE), U1.P17 (GNDCORE), U1.R10 (GNDCORE), U1.R12 (GNDCORE), U1.R14 (GNDCORE), U1.R16 (GNDCORE), U1.T11 (GNDCORE), U1.T13 (GNDCORE), U1.T15 (GNDCORE), U1.U13 (GNDCORE); also elsewhere on the board
VDD1V2: L1.1, L2.1, L3.1, L4.1, U1.J13 (VDDCORE), U1.K10 (CG0_DVDDPLL), U1.K12 (VDDCORE), U1.K14 (VDDCORE), U1.K16 (CG3_DVDDPLL), U1.L11 (VDDCORE), U1.L13 (VDDCORE), U1.L15 (VDDCORE), U1.M10 (VDDCORE), U1.M12 (VDDCORE), U1.M14 (VDDCORE), U1.M16 (VDDCORE), U1.N11 (VDDCORE), U1.N13 (VDDCORE), U1.N15 (VDDCORE), U1.N17 (VDDCORE), U1.P10 (VDDCORE), U1.P12 (VDDCORE), U1.P14 (VDDCORE), U1.P16 (VDDCORE), U1.R11 (VDDCORE), U1.R13 (VDDCORE), U1.R15 (VDDCORE), U1.T10 (CG1_DVDDPLL), U1.T12 (VDDCORE), U1.T14 (VDDCORE), U1.T16 (CG2_DVDDPLL), U1.U12 (VDDCORE), U1.U14 (VDDCORE); also elsewhere on the board
VDD2V5A: U1.A6 (VDD2V5A), U1.A13 (VDD2V5A), U1.A20 (VDD2V5A), U1.AE6 (VDD2V5A), U1.AE13 (VDD2V5A), U1.AE20 (VDD2V5A), U1.K1 (VDD2V5A), U1.K25 (VDD2V5A), U1.T1 (VDD2V5A), U1.T25 (VDD2V5A); also elsewhere on the board

Notes on the sheet:
FPGA Core Bank
FPGA core and PLL supply section. The 1.2 V core rail is locally filtered through a LC network to provide a low-noise supply for the PLL analog domain, with dedicated local decoupling. VDD2V5A is the dedicated 2.5 V auxiliary analog supply for the FPGA internal analog circuitry and is kept separate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

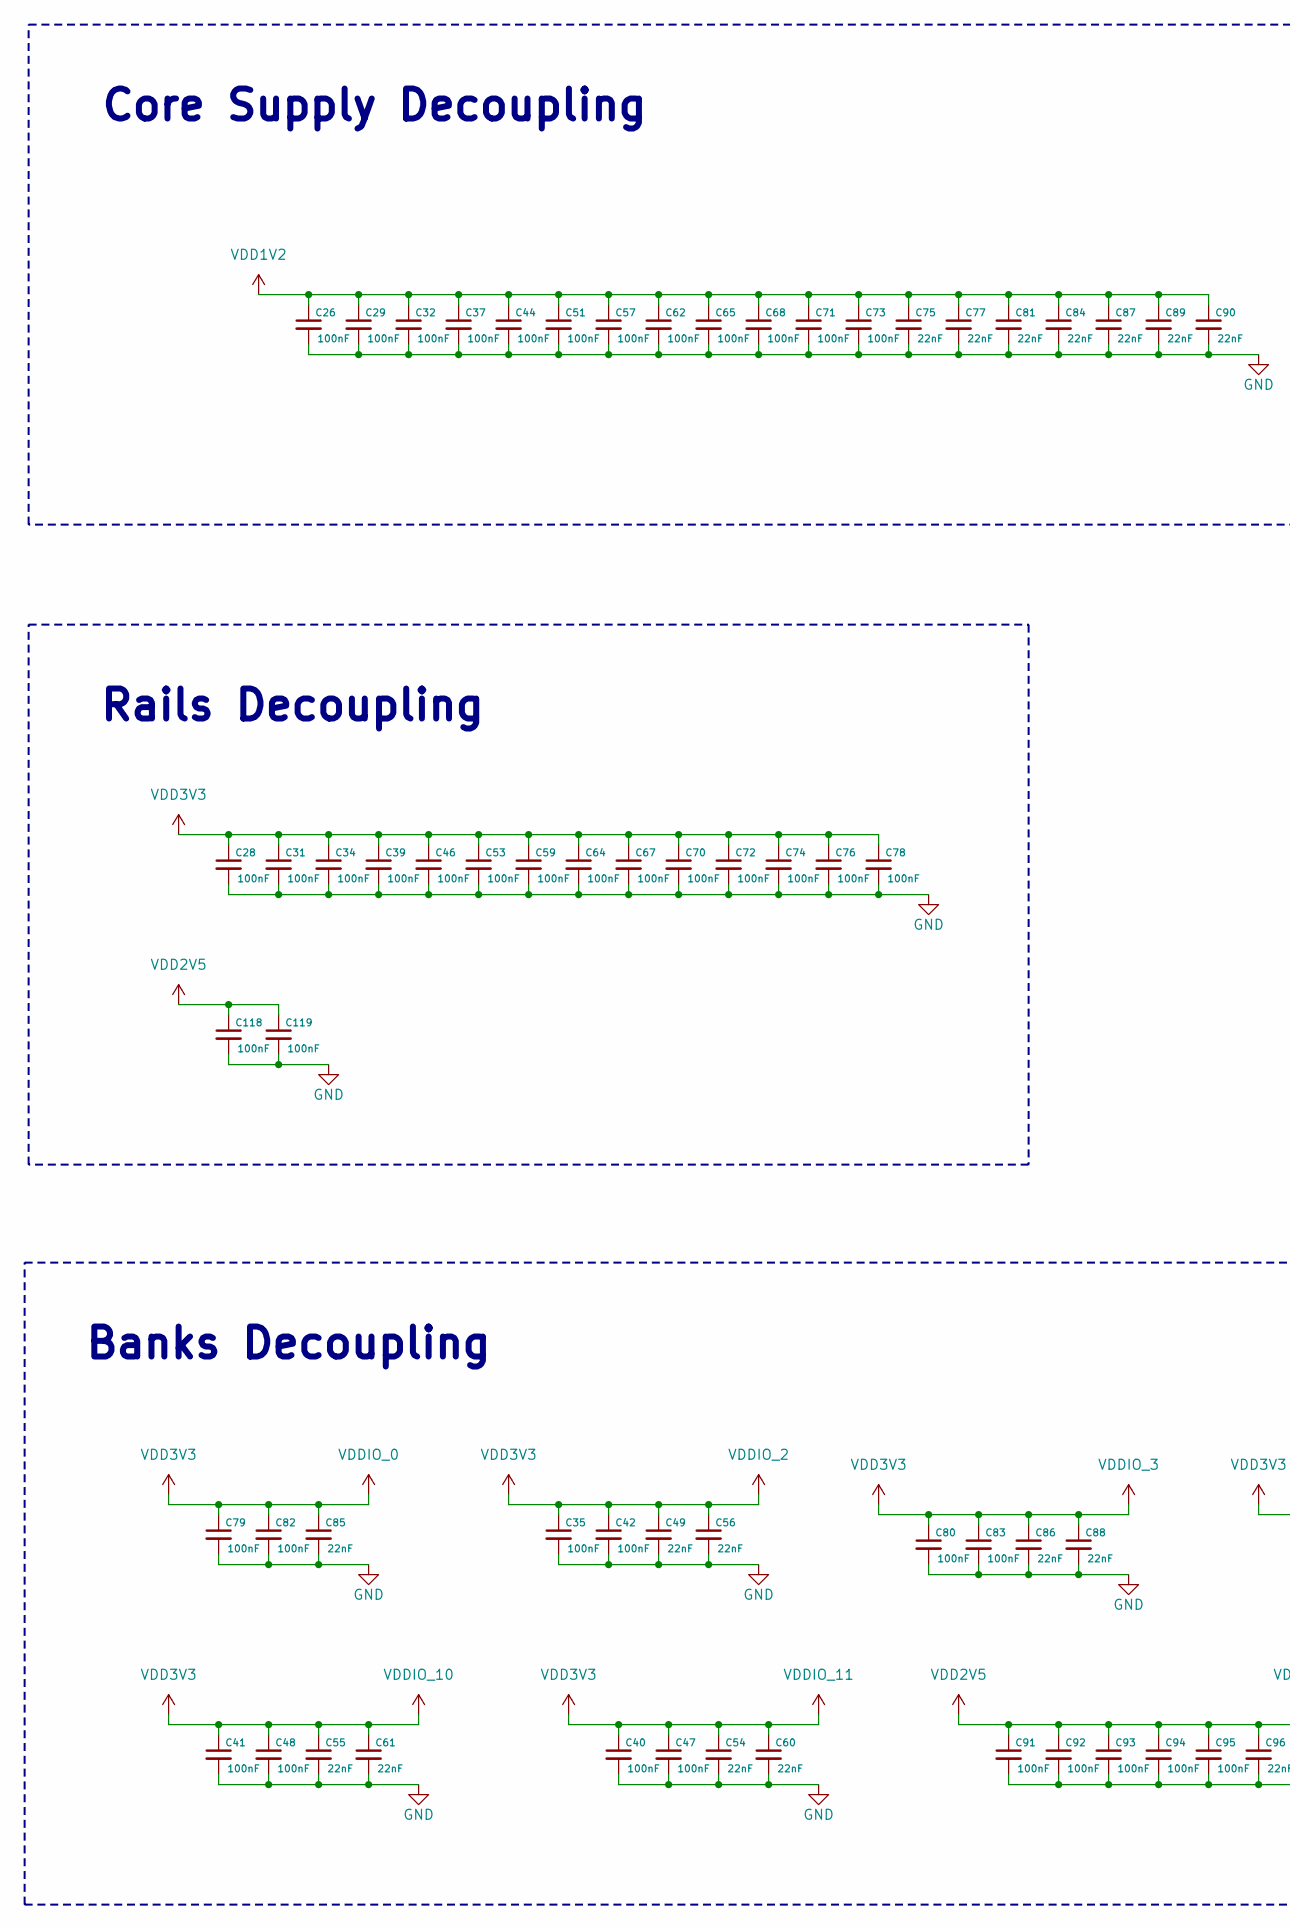
[picture p7: schematic Decoupling_Network.kicad_sch, Power Rails and FPGA Banks Decoupling, part in row 1, column 1]

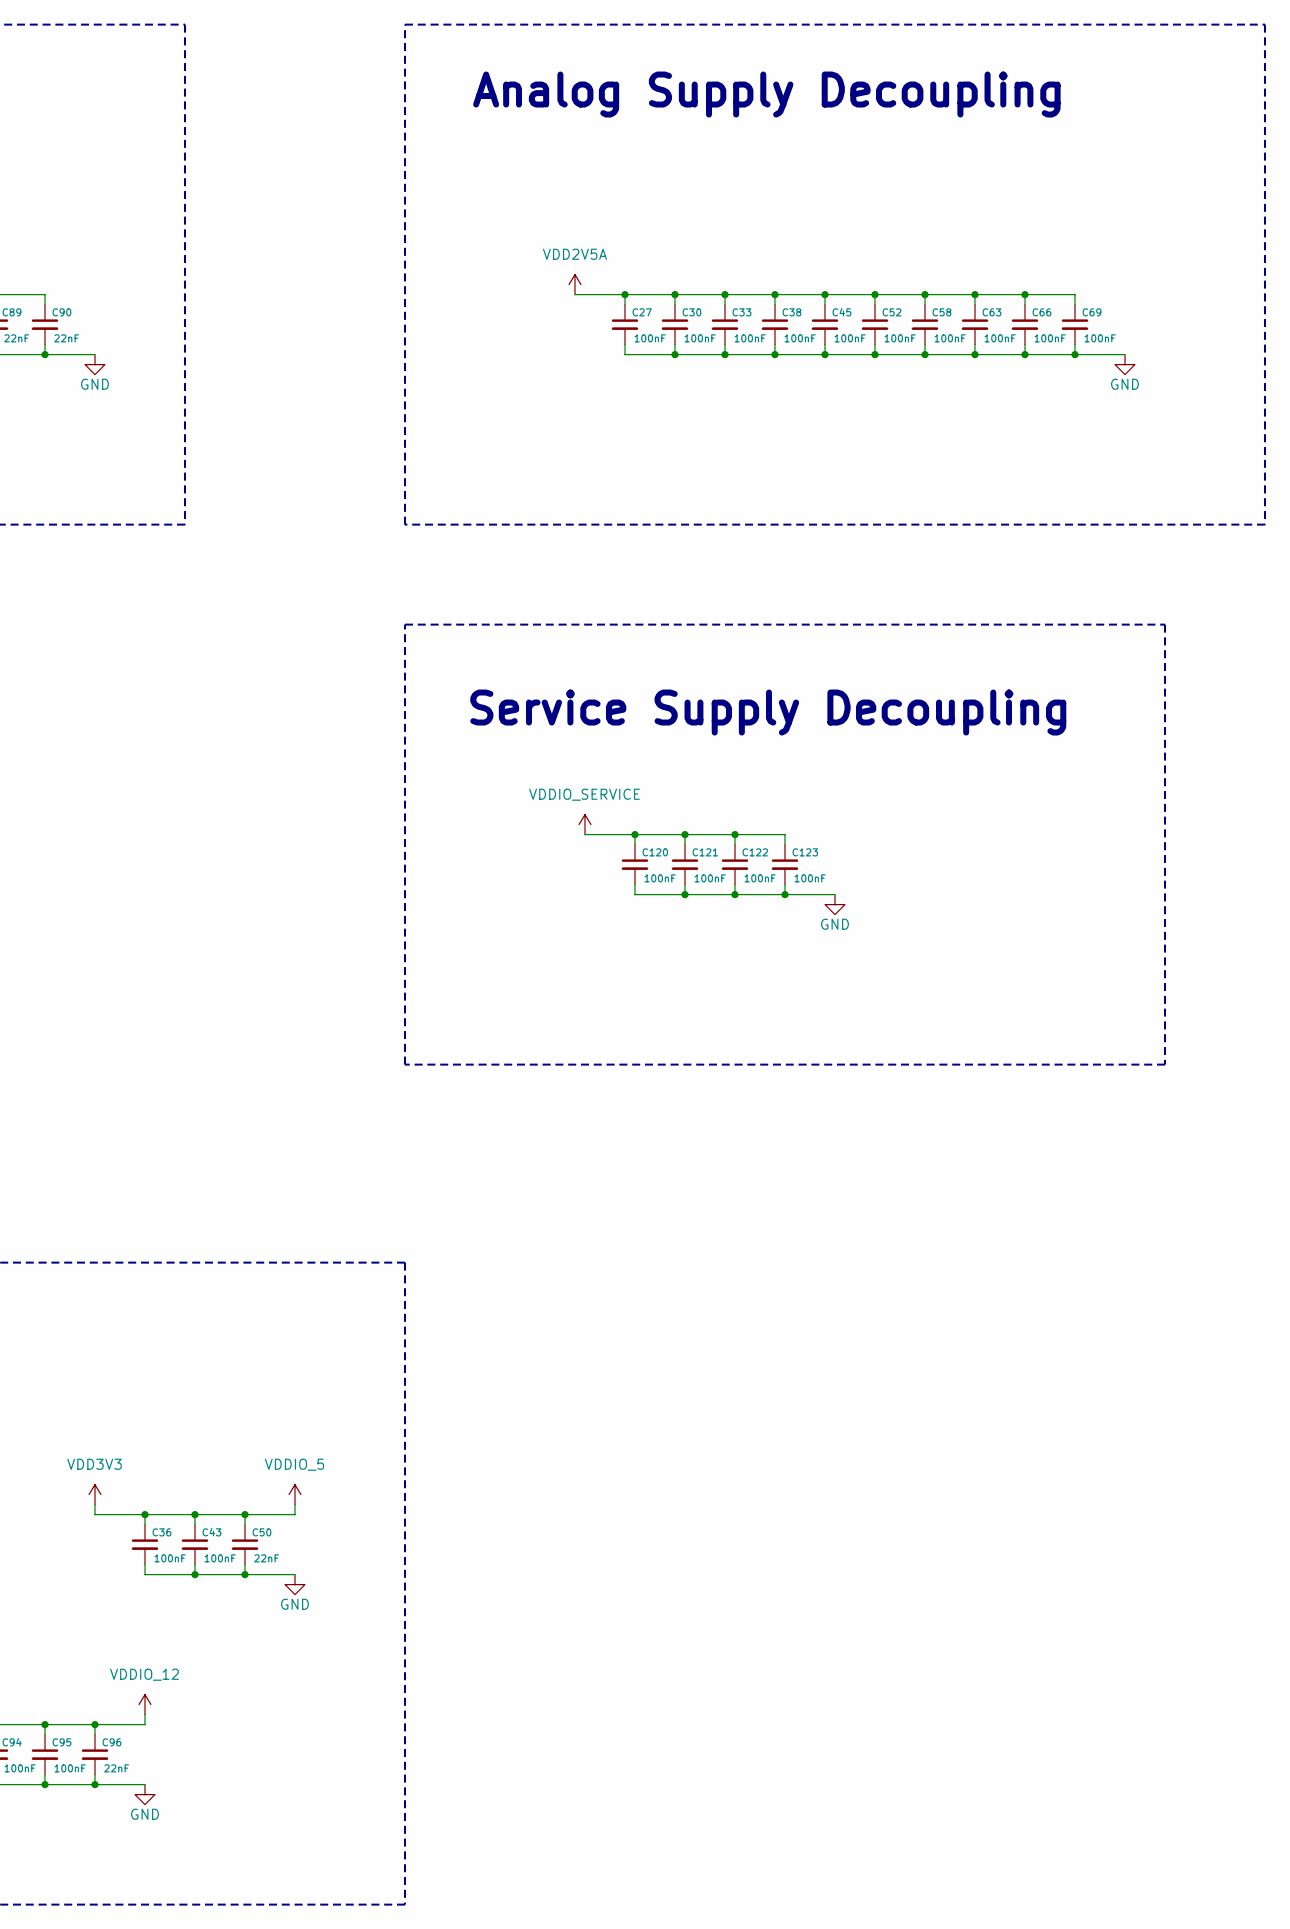
[picture p8: schematic Decoupling_Network.kicad_sch, Power Rails and FPGA Banks Decoupling, part in row 1, column 2]

Parts:
C26, C27, C28, C29, C30, C31, C32, C33, C34, C35, C36, C37, C38, C39, C40, C41, C42, C43, C44, C45, C46, C47, C48, C51, C52, C53, C57, C58, C59, C62, C63, C64, C65, C66, C67, C68, C69, C70, C71, C72, C73, C74, C76, C78, C79, C80, C82, C83, C91, C92, C93, C94, C95, C118, C119, C120, C121, C122, C123: 100nF; C_0402_1005Metric_Pad0.74x0.62mm_HandSolder
C49, C50, C54, C55, C56, C60, C61, C75, C77, C81, C84, C85, C86, C87, C88, C89, C90, C96: 22nF; C_0402_1005Metric_Pad0.74x0.62mm_HandSolder

Connections:
GND: C26.2, C27.2, C28.2, C29.2, C30.2, C31.2, C32.2, C33.2, C34.2, C35.2, C36.2, C37.2, C38.2, C39.2, C40.2, C41.2, C42.2, C43.2, C44.2, C45.2, C46.2, C47.2, C48.2, C49.2, C50.2, C51.2, C52.2, C53.2, C54.2, C55.2, C56.2, C57.2, C58.2, C59.2, C60.2, C61.2, C62.2, C63.2, C64.2, C65.2, C66.2, C67.2, C68.2, C69.2, C70.2, C71.2, C72.2, C73.2, C74.2, C75.2, C76.2, C77.2, C78.2, C79.2, C80.2, C81.2, C82.2, C83.2, C84.2, C85.2, C86.2, C87.2, C88.2, C89.2, C90.2, C91.2, C92.2, C93.2, C94.2, C95.2, C96.2, C118.2, C119.2, C120.2, C121.2, C122.2, C123.2; also elsewhere on the board
VDD1V2: C26.1, C29.1, C32.1, C37.1, C44.1, C51.1, C57.1, C62.1, C65.1, C68.1, C71.1, C73.1, C75.1, C77.1, C81.1, C84.1, C87.1, C89.1, C90.1; also elsewhere on the board
VDD2V5: C91.1, C92.1, C93.1, C94.1, C95.1, C96.1, C118.1, C119.1; also elsewhere on the board
VDD2V5A: C27.1, C30.1, C33.1, C38.1, C45.1, C52.1, C58.1, C63.1, C66.1, C69.1; also elsewhere on the board
VDD3V3: C28.1, C31.1, C34.1, C35.1, C36.1, C39.1, C40.1, C41.1, C42.1, C43.1, C46.1, C47.1, C48.1, C49.1, C50.1, C53.1, C54.1, C55.1, C56.1, C59.1, C60.1, C61.1, C64.1, C67.1, C70.1, C72.1, C74.1, C76.1, C78.1, C79.1, C80.1, C82.1, C83.1, C85.1, C86.1, C88.1; also elsewhere on the board
VDDIO_SERVICE: C120.1, C121.1, C122.1, C123.1; also elsewhere on the board

Notes on the sheet:
Rails Decoupling
Core Supply Decoupling
Banks Decoupling
Service Supply Decoupling
Analog Supply Decoupling

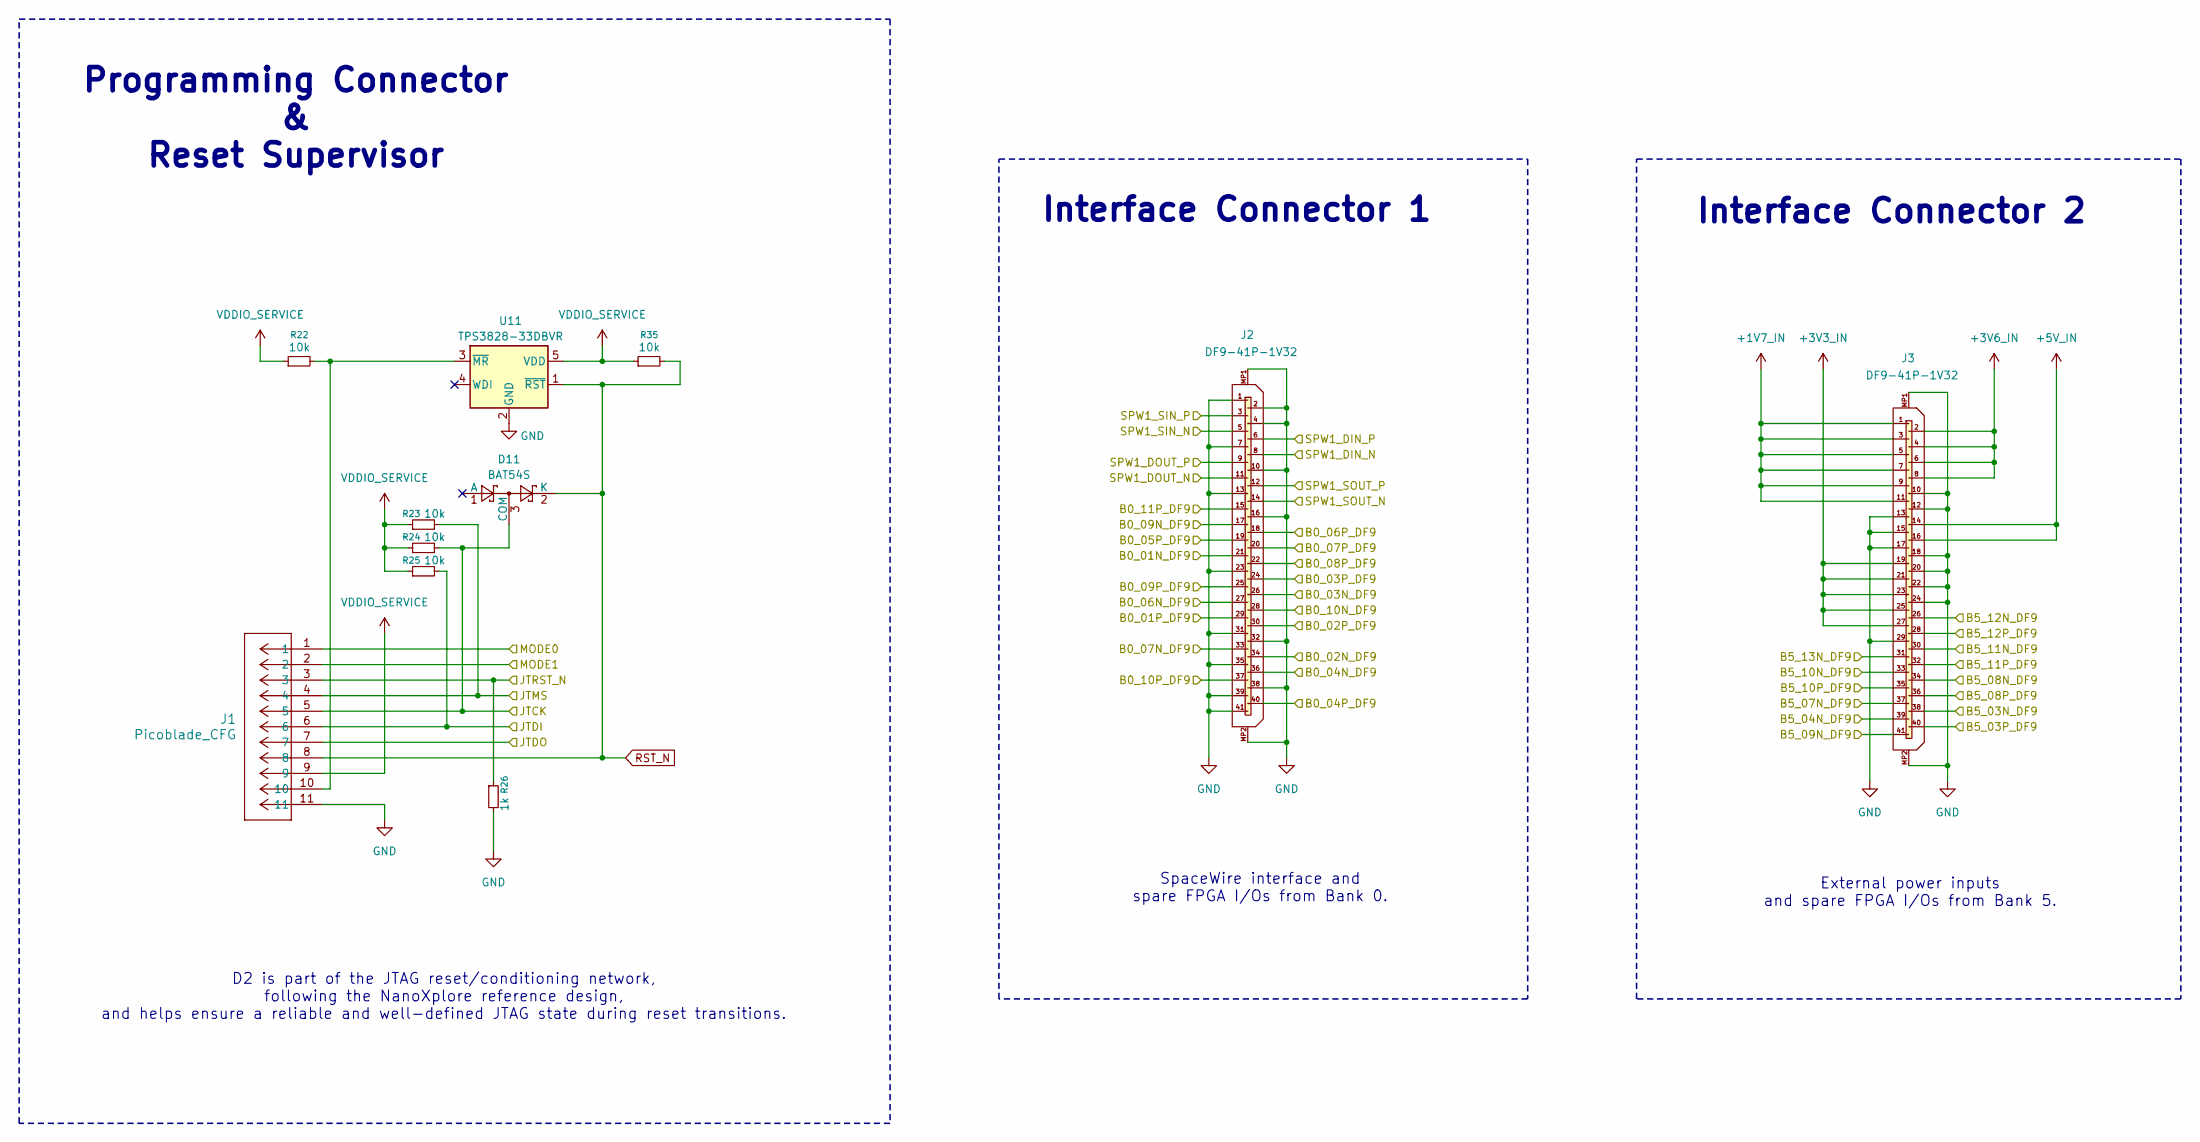
[picture p9: schematic Connectors_DF9_PicoB.kicad_sch, Board Connectors - DF9s and PicoBlade]

Parts:
D11: BAT54S; SOT-23
J1: Picoblade_CFG; CONN_532610001-SD_11_MOL
J2, J3: DF9-41P-1V32; DF941P1V32
R22, R23, R24, R25, R35: 10k; R_0402_1005Metric_Pad0.72x0.64mm_HandSolder
R26: 1k; R_0402_1005Metric_Pad0.72x0.64mm_HandSolder
U11: TPS3828-33DBVR; SOT-23-5_HandSoldering

Connections:
+1V7_IN: J3.1, J3.3, J3.5, J3.7, J3.9, J3.11; also elsewhere on the board
+3V3_IN: J3.19, J3.21, J3.23, J3.25, J3.27; also elsewhere on the board
+3V6_IN: J3.2, J3.4, J3.6, J3.8; also elsewhere on the board
+5V_IN: J3.14, J3.16; also elsewhere on the board
/Connectors_DF9_PicoB/B0_01N_DF9: J2.21; also elsewhere on the board
/Connectors_DF9_PicoB/B0_01P_DF9: J2.29; also elsewhere on the board
/Connectors_DF9_PicoB/B0_02N_DF9: J2.34; also elsewhere on the board
/Connectors_DF9_PicoB/B0_02P_DF9: J2.30; also elsewhere on the board
/Connectors_DF9_PicoB/B0_03N_DF9: J2.26; also elsewhere on the board
/Connectors_DF9_PicoB/B0_03P_DF9: J2.24; also elsewhere on the board
/Connectors_DF9_PicoB/B0_04N_DF9: J2.36; also elsewhere on the board
/Connectors_DF9_PicoB/B0_04P_DF9: J2.40; also elsewhere on the board
/Connectors_DF9_PicoB/B0_05P_DF9: J2.19; also elsewhere on the board
/Connectors_DF9_PicoB/B0_06N_DF9: J2.27; also elsewhere on the board
/Connectors_DF9_PicoB/B0_06P_DF9: J2.18; also elsewhere on the board
/Connectors_DF9_PicoB/B0_07N_DF9: J2.33; also elsewhere on the board
/Connectors_DF9_PicoB/B0_07P_DF9: J2.20; also elsewhere on the board
/Connectors_DF9_PicoB/B0_08P_DF9: J2.22; also elsewhere on the board
/Connectors_DF9_PicoB/B0_09N_DF9: J2.17; also elsewhere on the board
/Connectors_DF9_PicoB/B0_09P_DF9: J2.25; also elsewhere on the board
/Connectors_DF9_PicoB/B0_10N_DF9: J2.28; also elsewhere on the board
/Connectors_DF9_PicoB/B0_10P_DF9: J2.37; also elsewhere on the board
/Connectors_DF9_PicoB/B0_11P_DF9: J2.15; also elsewhere on the board
/Connectors_DF9_PicoB/B5_03N_DF9: J3.38; also elsewhere on the board
/Connectors_DF9_PicoB/B5_03P_DF9: J3.40; also elsewhere on the board
/Connectors_DF9_PicoB/B5_04N_DF9: J3.39; also elsewhere on the board
/Connectors_DF9_PicoB/B5_07N_DF9: J3.37; also elsewhere on the board
/Connectors_DF9_PicoB/B5_08N_DF9: J3.34; also elsewhere on the board
/Connectors_DF9_PicoB/B5_08P_DF9: J3.36; also elsewhere on the board
/Connectors_DF9_PicoB/B5_09N_DF9: J3.41; also elsewhere on the board
/Connectors_DF9_PicoB/B5_10N_DF9: J3.33; also elsewhere on the board
/Connectors_DF9_PicoB/B5_10P_DF9: J3.35; also elsewhere on the board
/Connectors_DF9_PicoB/B5_11N_DF9: J3.30; also elsewhere on the board
/Connectors_DF9_PicoB/B5_11P_DF9: J3.32; also elsewhere on the board
/Connectors_DF9_PicoB/B5_12N_DF9: J3.26; also elsewhere on the board
/Connectors_DF9_PicoB/B5_12P_DF9: J3.28; also elsewhere on the board
/Connectors_DF9_PicoB/B5_13N_DF9: J3.31; also elsewhere on the board
/Connectors_DF9_PicoB/JTCK: D11.3 (COM), J1.5, R24.2; also elsewhere on the board
/Connectors_DF9_PicoB/JTDI: J1.6, R25.2; also elsewhere on the board
/Connectors_DF9_PicoB/JTDO: J1.7; also elsewhere on the board
/Connectors_DF9_PicoB/JTMS: J1.4, R23.2; also elsewhere on the board
/Connectors_DF9_PicoB/JTRST_N: J1.3, R26.1; also elsewhere on the board
/Connectors_DF9_PicoB/MODE0: J1.1; also elsewhere on the board
/Connectors_DF9_PicoB/MODE1: J1.2; also elsewhere on the board
/Connectors_DF9_PicoB/SPW1_DIN_N: J2.8; also elsewhere on the board
/Connectors_DF9_PicoB/SPW1_DIN_P: J2.6; also elsewhere on the board
/Connectors_DF9_PicoB/SPW1_DOUT_N: J2.11; also elsewhere on the board
/Connectors_DF9_PicoB/SPW1_DOUT_P: J2.9; also elsewhere on the board
/Connectors_DF9_PicoB/SPW1_SIN_N: J2.5; also elsewhere on the board
/Connectors_DF9_PicoB/SPW1_SIN_P: J2.3; also elsewhere on the board
/Connectors_DF9_PicoB/SPW1_SOUT_N: J2.14; also elsewhere on the board
/Connectors_DF9_PicoB/SPW1_SOUT_P: J2.12; also elsewhere on the board
GND: J1.11, J2.1, J2.2, J2.4, J2.7, J2.10, J2.13, J2.16, J2.23, J2.31, J2.32, J2.35, J2.38, J2.39, J2.41, J2.MP1, J2.MP2, J3.10, J3.12, J3.13, J3.15, J3.17, J3.18, J3.20, J3.22, J3.24, J3.29, J3.MP1, J3.MP2, R26.2, U11.2 (GND); also elsewhere on the board
unnamed: J1.10, R22.2, U11.3 (~MR)
RST_N: D11.2 (K), J1.8, R35.2, U11.1 (~RST); also elsewhere on the board
VDDIO_SERVICE: J1.9, R22.1, R23.1, R24.1, R25.1, R35.1, U11.5 (VDD); also elsewhere on the board

Notes on the sheet:
SpaceWire interface and spare FPGA I/Os from Bank 0.
Interface Connector 2
External power inputs and spare FPGA I/Os from Bank 5.
Programming Connector & Reset Supervisor
Interface Connector 1
D2 is part of the JTAG reset/conditioning network, following the NanoXplore reference design, and helps ensure a reliable and well-defined JTAG state during reset transitions.

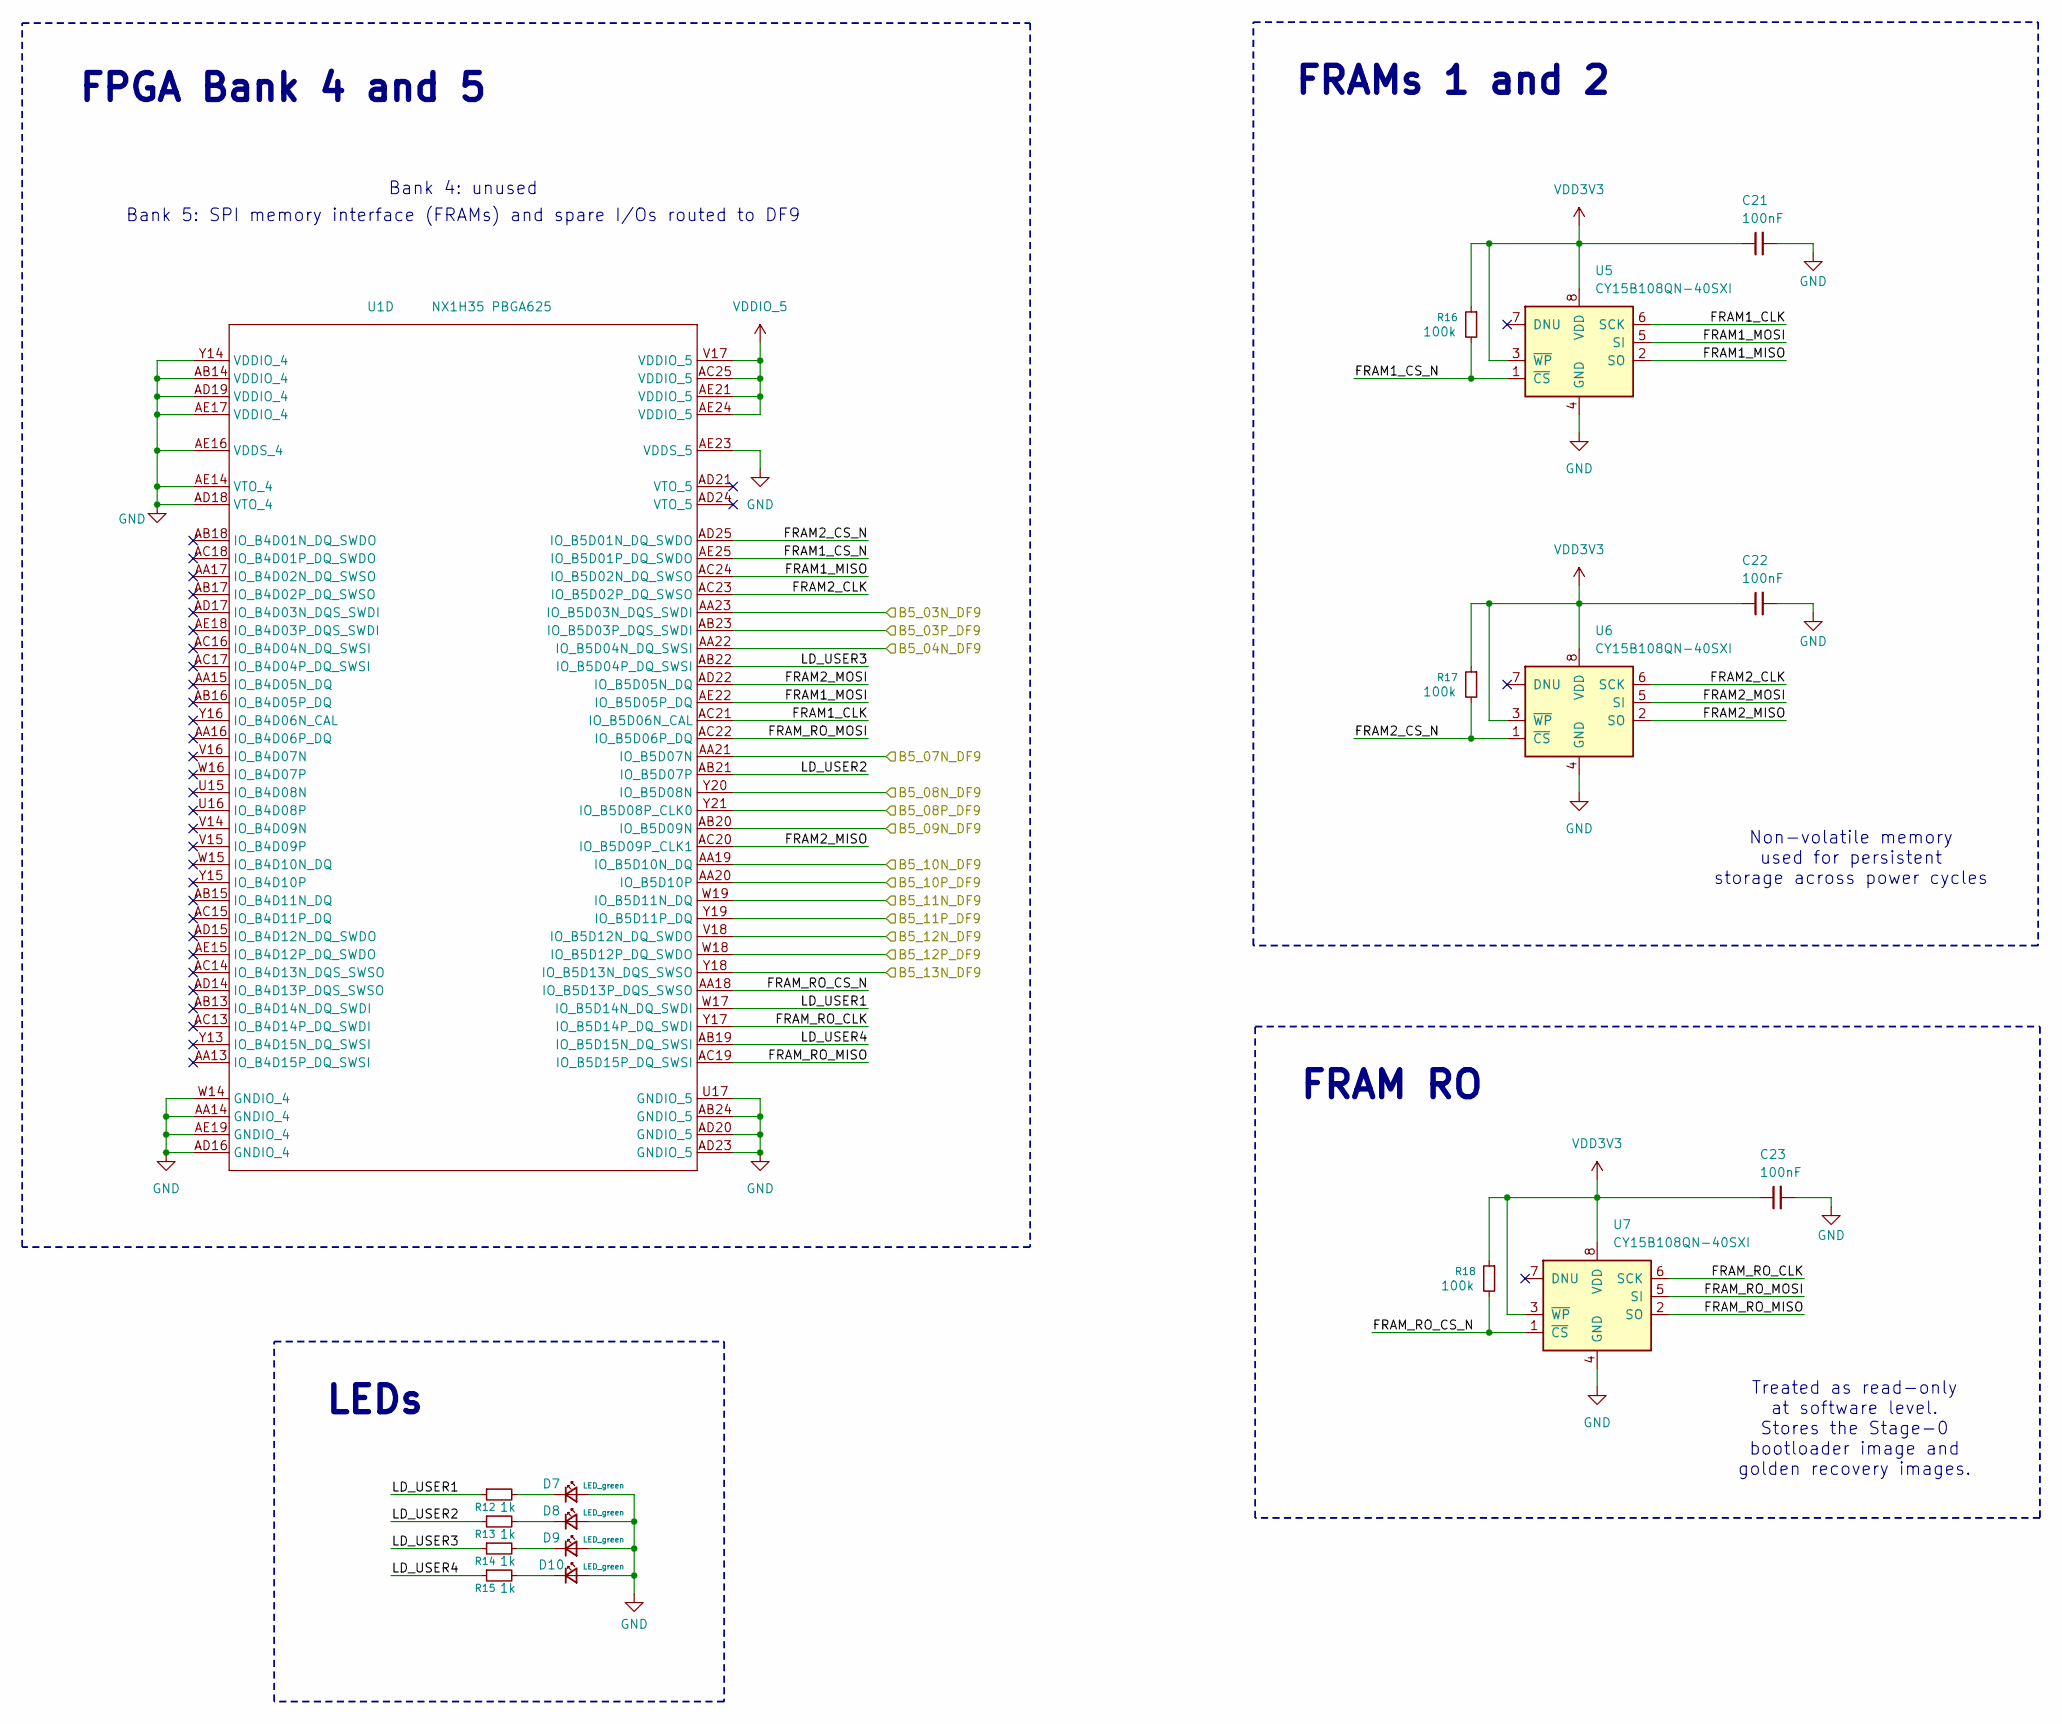
[picture p10: schematic FPGA_Banks4_5_SPI.kicad_sch, SPI Memory Interface - FPGA Banks 4 and 5]

Parts:
C21, C22, C23: 100nF; C_0402_1005Metric_Pad0.74x0.62mm_HandSolder
D7, D8, D9, D10: LED_green; LED_0603_1608Metric
R12, R13, R14, R15: 1k; R_0402_1005Metric_Pad0.72x0.64mm_HandSolder
R16, R17, R18: 100k; R_0402_1005Metric_Pad0.72x0.64mm_HandSolder
U1: NX1H35 PBGA625; NX1H35S_CLGA625
U5, U6, U7: CY15B108QN-40SXI; SOIC8_001-85261_CYP

Connections:
/Connectors_DF9_PicoB/B5_03N_DF9: U1.AA23 (IO_B5D03N_DQS_SWDI); also elsewhere on the board
/Connectors_DF9_PicoB/B5_03P_DF9: U1.AB23 (IO_B5D03P_DQS_SWDI); also elsewhere on the board
/Connectors_DF9_PicoB/B5_04N_DF9: U1.AA22 (IO_B5D04N_DQ_SWSI); also elsewhere on the board
/Connectors_DF9_PicoB/B5_07N_DF9: U1.AA21 (IO_B5D07N); also elsewhere on the board
/Connectors_DF9_PicoB/B5_08N_DF9: U1.Y20 (IO_B5D08N); also elsewhere on the board
/Connectors_DF9_PicoB/B5_08P_DF9: U1.Y21 (IO_B5D08P_CLK0); also elsewhere on the board
/Connectors_DF9_PicoB/B5_09N_DF9: U1.AB20 (IO_B5D09N); also elsewhere on the board
/Connectors_DF9_PicoB/B5_10N_DF9: U1.AA19 (IO_B5D10N_DQ); also elsewhere on the board
/Connectors_DF9_PicoB/B5_10P_DF9: U1.AA20 (IO_B5D10P); also elsewhere on the board
/Connectors_DF9_PicoB/B5_11N_DF9: U1.W19 (IO_B5D11N_DQ); also elsewhere on the board
/Connectors_DF9_PicoB/B5_11P_DF9: U1.Y19 (IO_B5D11P_DQ); also elsewhere on the board
/Connectors_DF9_PicoB/B5_12N_DF9: U1.V18 (IO_B5D12N_DQ_SWDO); also elsewhere on the board
/Connectors_DF9_PicoB/B5_12P_DF9: U1.W18 (IO_B5D12P_DQ_SWDO); also elsewhere on the board
/Connectors_DF9_PicoB/B5_13N_DF9: U1.Y18 (IO_B5D13N_DQS_SWSO); also elsewhere on the board
/FPGA_Banks4_5_SPI/FRAM1_CLK: U1.AC21 (IO_B5D06N_CAL), U5.6 (SCK)
/FPGA_Banks4_5_SPI/FRAM1_CS_N: R16.2, U1.AE25 (IO_B5D01P_DQ_SWDO), U5.1 (~CS)
/FPGA_Banks4_5_SPI/FRAM1_MISO: U1.AC24 (IO_B5D02N_DQ_SWSO), U5.2 (SO)
/FPGA_Banks4_5_SPI/FRAM1_MOSI: U1.AE22 (IO_B5D05P_DQ), U5.5 (SI)
/FPGA_Banks4_5_SPI/FRAM2_CLK: U1.AC23 (IO_B5D02P_DQ_SWSO), U6.6 (SCK)
/FPGA_Banks4_5_SPI/FRAM2_CS_N: R17.2, U1.AD25 (IO_B5D01N_DQ_SWDO), U6.1 (~CS)
/FPGA_Banks4_5_SPI/FRAM2_MISO: U1.AC20 (IO_B5D09P_CLK1), U6.2 (SO)
/FPGA_Banks4_5_SPI/FRAM2_MOSI: U1.AD22 (IO_B5D05N_DQ), U6.5 (SI)
/FPGA_Banks4_5_SPI/FRAM_RO_CLK: U1.Y17 (IO_B5D14P_DQ_SWDI), U7.6 (SCK)
/FPGA_Banks4_5_SPI/FRAM_RO_CS_N: R18.2, U1.AA18 (IO_B5D13P_DQS_SWSO), U7.1 (~CS)
/FPGA_Banks4_5_SPI/FRAM_RO_MISO: U1.AC19 (IO_B5D15P_DQ_SWSI), U7.2 (SO)
/FPGA_Banks4_5_SPI/FRAM_RO_MOSI: U1.AC22 (IO_B5D06P_DQ), U7.5 (SI)
/FPGA_Banks4_5_SPI/LD_USER1: R12.1, U1.W17 (IO_B5D14N_DQ_SWDI)
/FPGA_Banks4_5_SPI/LD_USER2: R13.1, U1.AB21 (IO_B5D07P)
/FPGA_Banks4_5_SPI/LD_USER3: R14.1, U1.AB22 (IO_B5D04P_DQ_SWSI)
/FPGA_Banks4_5_SPI/LD_USER4: R15.1, U1.AB19 (IO_B5D15N_DQ_SWSI)
GND: C21.2, C22.2, C23.2, D7.2 (A), D8.2 (A), D9.2 (A), D10.2 (A), U1.AA14 (GNDIO_4), U1.AB14 (VDDIO_4), U1.AB24 (GNDIO_5), U1.AD16 (GNDIO_4), U1.AD18 (VTO_4), U1.AD19 (VDDIO_4), U1.AD20 (GNDIO_5), U1.AD23 (GNDIO_5), U1.AE14 (VTO_4), U1.AE16 (VDDS_4), U1.AE17 (VDDIO_4), U1.AE19 (GNDIO_4), U1.AE23 (VDDS_5), U1.U17 (GNDIO_5), U1.W14 (GNDIO_4), U1.Y14 (VDDIO_4), U5.4 (GND), U6.4 (GND), U7.4 (GND); also elsewhere on the board
unnamed: D7.1 (K), R12.2
unnamed: D8.1 (K), R13.2
unnamed: D9.1 (K), R14.2
unnamed: D10.1 (K), R15.2
VDD3V3: C21.1, C22.1, C23.1, R16.1, R17.1, R18.1, U1.AC25 (VDDIO_5), U1.AE21 (VDDIO_5), U1.AE24 (VDDIO_5), U1.V17 (VDDIO_5), U5.3 (~WP), U5.8 (VDD), U6.3 (~WP), U6.8 (VDD), U7.3 (~WP), U7.8 (VDD); also elsewhere on the board

Notes on the sheet:
Treated as read-only at software level. Stores the Stage-0 bootloader image and golden recovery images.
Bank 4: unused
LEDs
Non-volatile memory used for persistent storage across power cycles
Bank 5: SPI memory interface (FRAMs) and spare I/Os routed to DF9
FPGA Bank 4 and 5
FRAMs 1 and 2
FRAM RO
