caloangelo/NG-MEDIUM_NX1H35AS_KiCad_repo/PCB_Project.kicad_pcb

## KiCad design PCB_Project.kicad_pcb (continued)

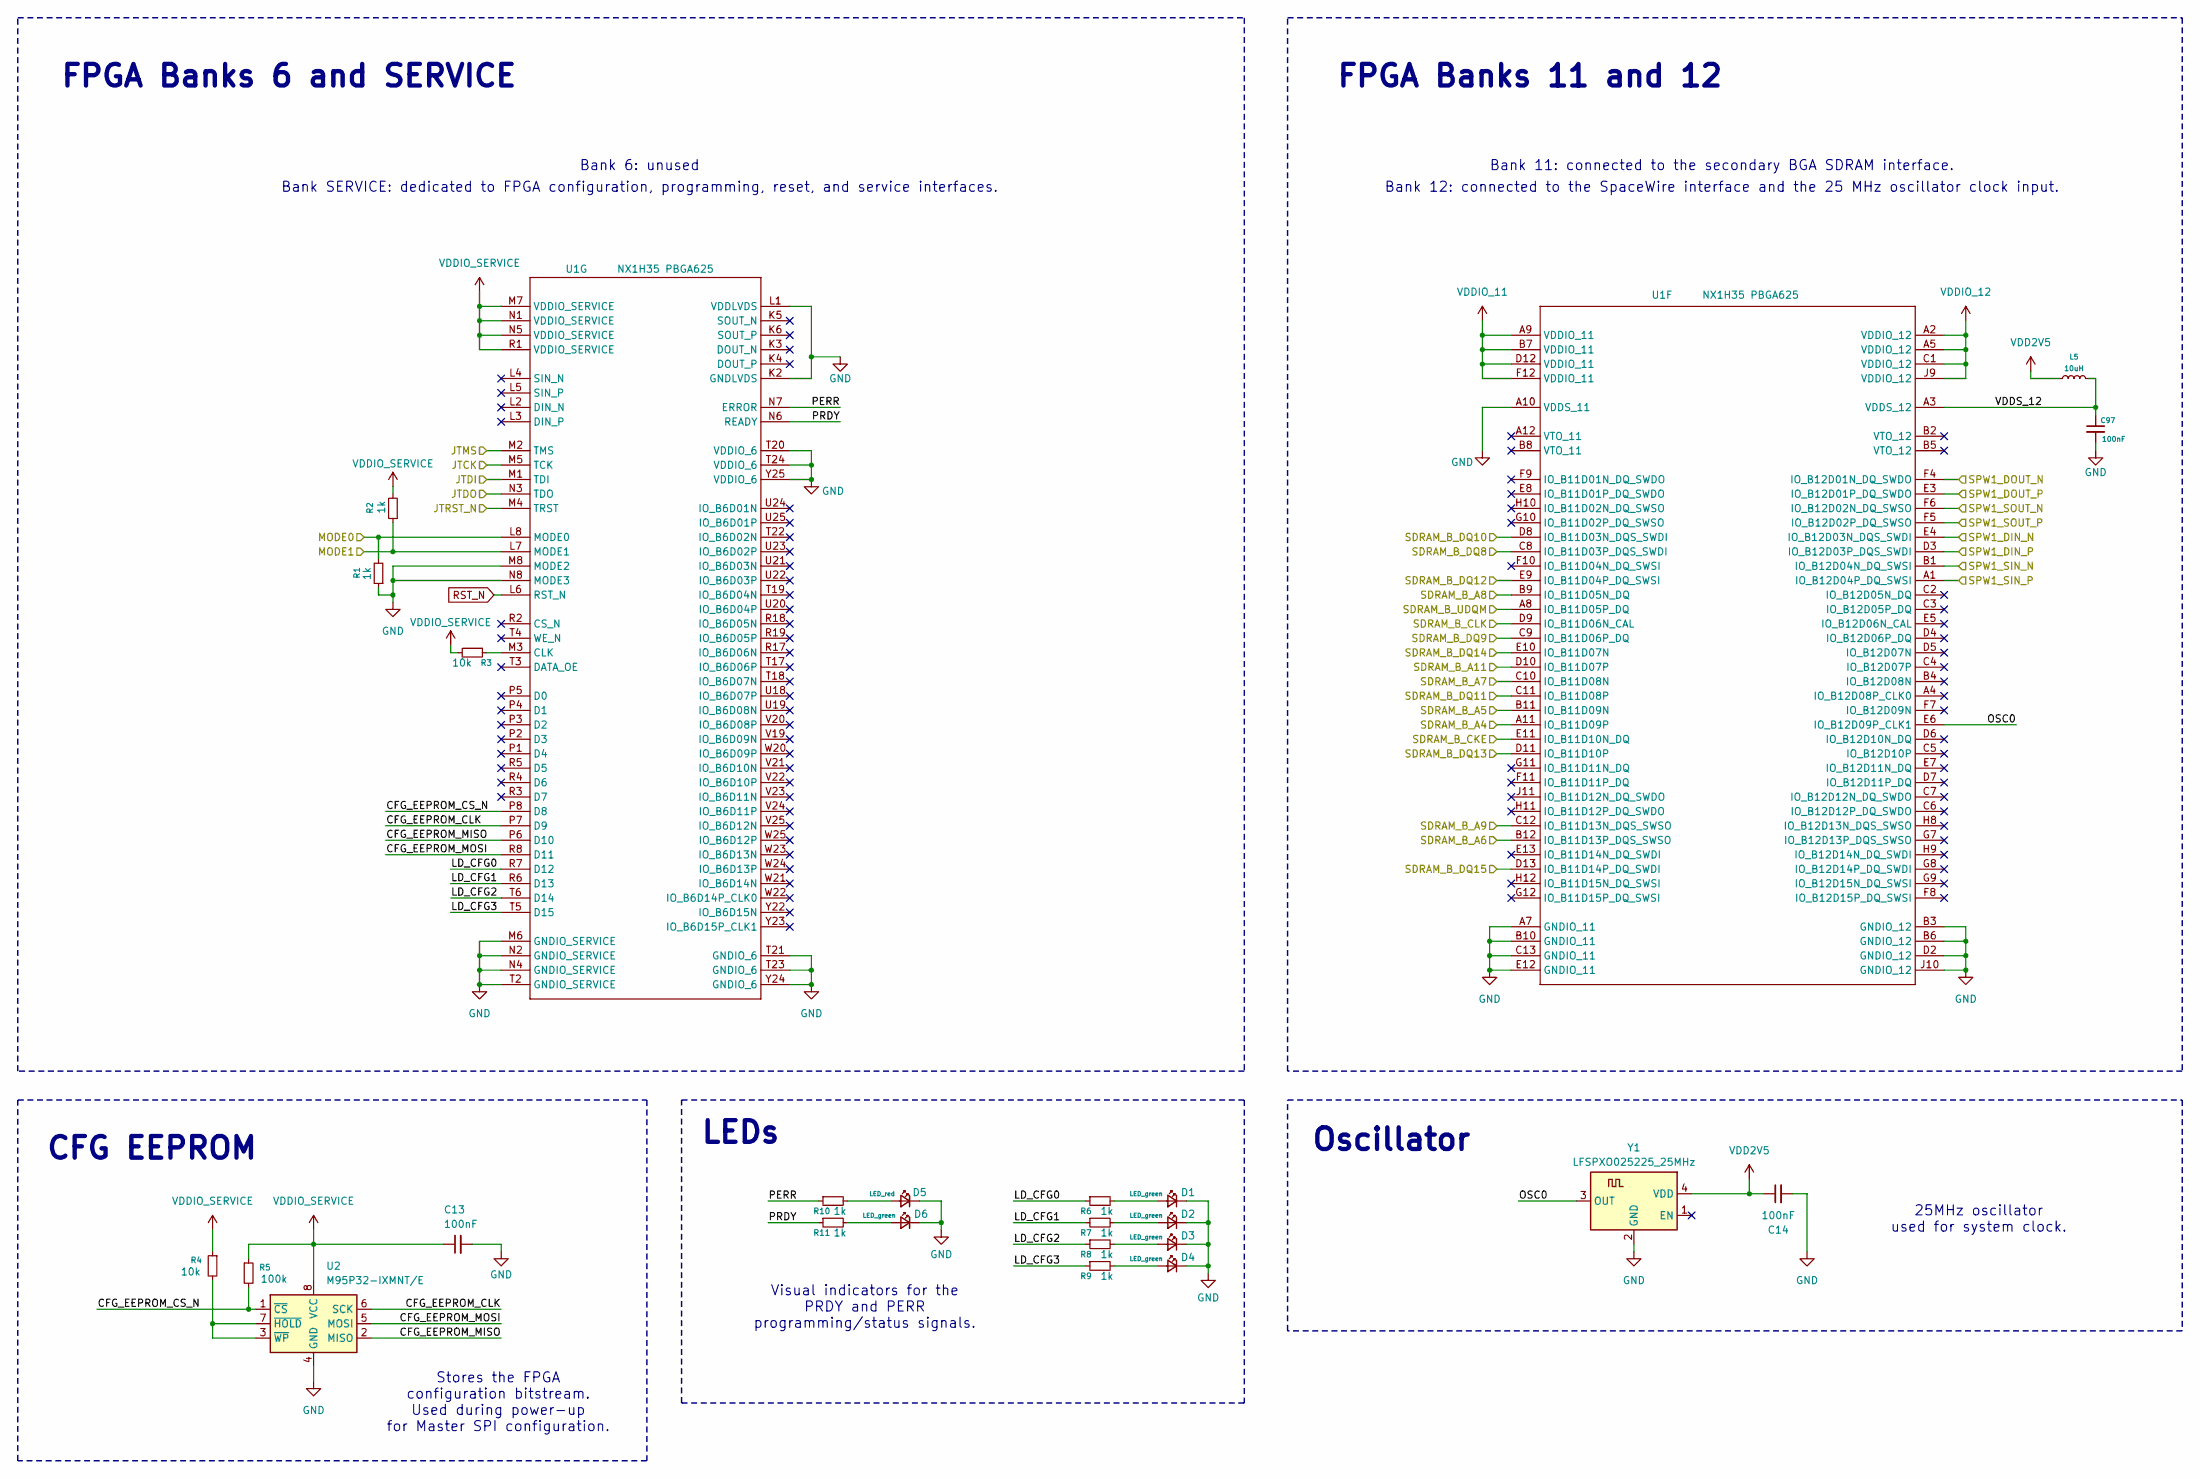
[picture p11: schematic FPGA_Banks11_12_CFG_Service.kicad_sch, FPGA Configuration, Service and Banks 11-12]

Parts:
C13, C14, C97: 100nF; C_0402_1005Metric_Pad0.74x0.62mm_HandSolder
D1, D2, D3, D4, D6: LED_green; LED_0603_1608Metric
D5: LED_red; LED_0603_1608Metric
L5: 10uH; L_0603_1608Metric_Pad1.05x0.95mm_HandSolder
R1, R2, R6, R7, R8, R9, R10, R11: 1k; R_0402_1005Metric_Pad0.72x0.64mm_HandSolder
R3, R4: 10k; R_0402_1005Metric_Pad0.72x0.64mm_HandSolder
R5: 100k; R_0402_1005Metric_Pad0.72x0.64mm_HandSolder
U1: NX1H35 PBGA625; NX1H35S_CLGA625
U2: M95P32-IXMNT/E; SO8N_4X5X1P27_STM
Y1: LFSPXO025225_25MHz; SON4_LFSPXO025225_IQD-M

Connections:
/Connectors_DF9_PicoB/JTCK: U1.M5 (TCK); also elsewhere on the board
/Connectors_DF9_PicoB/JTDI: U1.M1 (TDI); also elsewhere on the board
/Connectors_DF9_PicoB/JTDO: U1.N3 (TDO); also elsewhere on the board
/Connectors_DF9_PicoB/JTMS: U1.M2 (TMS); also elsewhere on the board
/Connectors_DF9_PicoB/JTRST_N: U1.M4 (TRST); also elsewhere on the board
/Connectors_DF9_PicoB/MODE0: R1.2, U1.L8 (MODE0); also elsewhere on the board
/Connectors_DF9_PicoB/MODE1: R2.1, U1.L7 (MODE1); also elsewhere on the board
/Connectors_DF9_PicoB/SPW1_DIN_N: U1.E4 (IO_B12D03N_DQS_SWDI); also elsewhere on the board
/Connectors_DF9_PicoB/SPW1_DIN_P: U1.D3 (IO_B12D03P_DQS_SWDI); also elsewhere on the board
/Connectors_DF9_PicoB/SPW1_DOUT_N: U1.F4 (IO_B12D01N_DQ_SWDO); also elsewhere on the board
/Connectors_DF9_PicoB/SPW1_DOUT_P: U1.E3 (IO_B12D01P_DQ_SWDO); also elsewhere on the board
/Connectors_DF9_PicoB/SPW1_SIN_N: U1.B1 (IO_B12D04N_DQ_SWSI); also elsewhere on the board
/Connectors_DF9_PicoB/SPW1_SIN_P: U1.A1 (IO_B12D04P_DQ_SWSI); also elsewhere on the board
/Connectors_DF9_PicoB/SPW1_SOUT_N: U1.F6 (IO_B12D02N_DQ_SWSO); also elsewhere on the board
/Connectors_DF9_PicoB/SPW1_SOUT_P: U1.F5 (IO_B12D02P_DQ_SWSO); also elsewhere on the board
/FPGA_Banks11_12_CFG_Service/CFG_EEPROM_CLK: U1.P7 (D9), U2.6 (SCK)
/FPGA_Banks11_12_CFG_Service/CFG_EEPROM_CS_N: R5.2, U1.P8 (D8), U2.1 (~CS)
/FPGA_Banks11_12_CFG_Service/CFG_EEPROM_MISO: U1.P6 (D10), U2.2 (MISO)
/FPGA_Banks11_12_CFG_Service/CFG_EEPROM_MOSI: U1.R8 (D11), U2.5 (MOSI)
/FPGA_Banks11_12_CFG_Service/LD_CFG0: R6.1, U1.R7 (D12)
/FPGA_Banks11_12_CFG_Service/LD_CFG1: R7.1, U1.R6 (D13)
/FPGA_Banks11_12_CFG_Service/LD_CFG2: R8.1, U1.T6 (D14)
/FPGA_Banks11_12_CFG_Service/LD_CFG3: R9.1, U1.T5 (D15)
/FPGA_Banks11_12_CFG_Service/OSC0: U1.E6 (IO_B12D09P_CLK1), Y1.3 (OUT)
/FPGA_Banks11_12_CFG_Service/PERR: R10.1, U1.N7 (ERROR)
/FPGA_Banks11_12_CFG_Service/PRDY: R11.1, U1.N6 (READY)
/FPGA_Banks11_12_CFG_Service/SDRAM_B_A4: U1.A11 (IO_B11D09P); also elsewhere on the board
/FPGA_Banks11_12_CFG_Service/SDRAM_B_A5: U1.B11 (IO_B11D09N); also elsewhere on the board
/FPGA_Banks11_12_CFG_Service/SDRAM_B_A6: U1.B12 (IO_B11D13P_DQS_SWSO); also elsewhere on the board
/FPGA_Banks11_12_CFG_Service/SDRAM_B_A7: U1.C10 (IO_B11D08N); also elsewhere on the board
/FPGA_Banks11_12_CFG_Service/SDRAM_B_A8: U1.B9 (IO_B11D05N_DQ); also elsewhere on the board
/FPGA_Banks11_12_CFG_Service/SDRAM_B_A9: U1.C12 (IO_B11D13N_DQS_SWSO); also elsewhere on the board
/FPGA_Banks11_12_CFG_Service/SDRAM_B_A11: U1.D10 (IO_B11D07P); also elsewhere on the board
/FPGA_Banks11_12_CFG_Service/SDRAM_B_CKE: U1.E11 (IO_B11D10N_DQ); also elsewhere on the board
/FPGA_Banks11_12_CFG_Service/SDRAM_B_CLK: U1.D9 (IO_B11D06N_CAL); also elsewhere on the board
/FPGA_Banks11_12_CFG_Service/SDRAM_B_DQ8: U1.C8 (IO_B11D03P_DQS_SWDI); also elsewhere on the board
/FPGA_Banks11_12_CFG_Service/SDRAM_B_DQ9: U1.C9 (IO_B11D06P_DQ); also elsewhere on the board
/FPGA_Banks11_12_CFG_Service/SDRAM_B_DQ10: U1.D8 (IO_B11D03N_DQS_SWDI); also elsewhere on the board
/FPGA_Banks11_12_CFG_Service/SDRAM_B_DQ11: U1.C11 (IO_B11D08P); also elsewhere on the board
/FPGA_Banks11_12_CFG_Service/SDRAM_B_DQ12: U1.E9 (IO_B11D04P_DQ_SWSI); also elsewhere on the board
/FPGA_Banks11_12_CFG_Service/SDRAM_B_DQ13: U1.D11 (IO_B11D10P); also elsewhere on the board
/FPGA_Banks11_12_CFG_Service/SDRAM_B_DQ14: U1.E10 (IO_B11D07N); also elsewhere on the board
/FPGA_Banks11_12_CFG_Service/SDRAM_B_DQ15: U1.D13 (IO_B11D14P_DQ_SWDI); also elsewhere on the board
/FPGA_Banks11_12_CFG_Service/SDRAM_B_UDQM: U1.A8 (IO_B11D05P_DQ); also elsewhere on the board
/FPGA_Banks11_12_CFG_Service/VDDS_12: C97.1, L5.1, U1.A3 (VDDS_12)
GND: C13.2, C14.2, C97.2, D1.1 (K), D2.1 (K), D3.1 (K), D4.1 (K), D5.1 (K), D6.1 (K), R1.1, U1.A7 (GNDIO_11), U1.A10 (VDDS_11), U1.B3 (GNDIO_12), U1.B6 (GNDIO_12), U1.B10 (GNDIO_11), U1.C13 (GNDIO_11), U1.D2 (GNDIO_12), U1.E12 (GNDIO_11), U1.J10 (GNDIO_12), U1.K2 (GNDLVDS), U1.L1 (VDDLVDS), U1.M6 (GNDIO_SERVICE), U1.M8 (MODE2), U1.N2 (GNDIO_SERVICE), U1.N4 (GNDIO_SERVICE), U1.N8 (MODE3), U1.T2 (GNDIO_SERVICE), U1.T20 (VDDIO_6), U1.T21 (GNDIO_6), U1.T23 (GNDIO_6), U1.T24 (VDDIO_6), U1.Y24 (GNDIO_6), U1.Y25 (VDDIO_6), U2.4 (GND), Y1.2 (GND); also elsewhere on the board
unnamed: D1.2 (A), R6.2
unnamed: D2.2 (A), R7.2
unnamed: D3.2 (A), R8.2
unnamed: D4.2 (A), R9.2
unnamed: D5.2 (A), R10.2
unnamed: D6.2 (A), R11.2
unnamed: R3.1, U1.M3 (CLK)
unnamed: R4.2, U2.3 (~WP), U2.7 (~HOLD)
RST_N: U1.L6 (RST_N); also elsewhere on the board
VDD2V5: C14.1, L5.2, U1.A2 (VDDIO_12), U1.A5 (VDDIO_12), U1.C1 (VDDIO_12), U1.J9 (VDDIO_12), Y1.4 (VDD); also elsewhere on the board
VDD3V3: U1.A9 (VDDIO_11), U1.B7 (VDDIO_11), U1.D12 (VDDIO_11), U1.F12 (VDDIO_11); also elsewhere on the board
VDDIO_SERVICE: C13.1, R2.2, R3.2, R4.1, R5.1, U1.M7 (VDDIO_SERVICE), U1.N1 (VDDIO_SERVICE), U1.N5 (VDDIO_SERVICE), U1.R1 (VDDIO_SERVICE), U2.8 (VCC); also elsewhere on the board

Notes on the sheet:
Bank SERVICE: dedicated to FPGA configuration, programming, reset, and service interfaces.
Bank 12: connected to the SpaceWire interface and the 25 MHz oscillator clock input.
Oscillator
Stores the FPGA configuration bitstream. Used during power-up for Master SPI configuration.
Bank 11: connected to the secondary BGA SDRAM interface.
25MHz oscillator used for system clock.
CFG EEPROM
FPGA Banks 6 and SERVICE
LEDs
Bank 6: unused
FPGA Banks 11 and 12
Visual indicators for the PRDY and PERR programming/status signals.

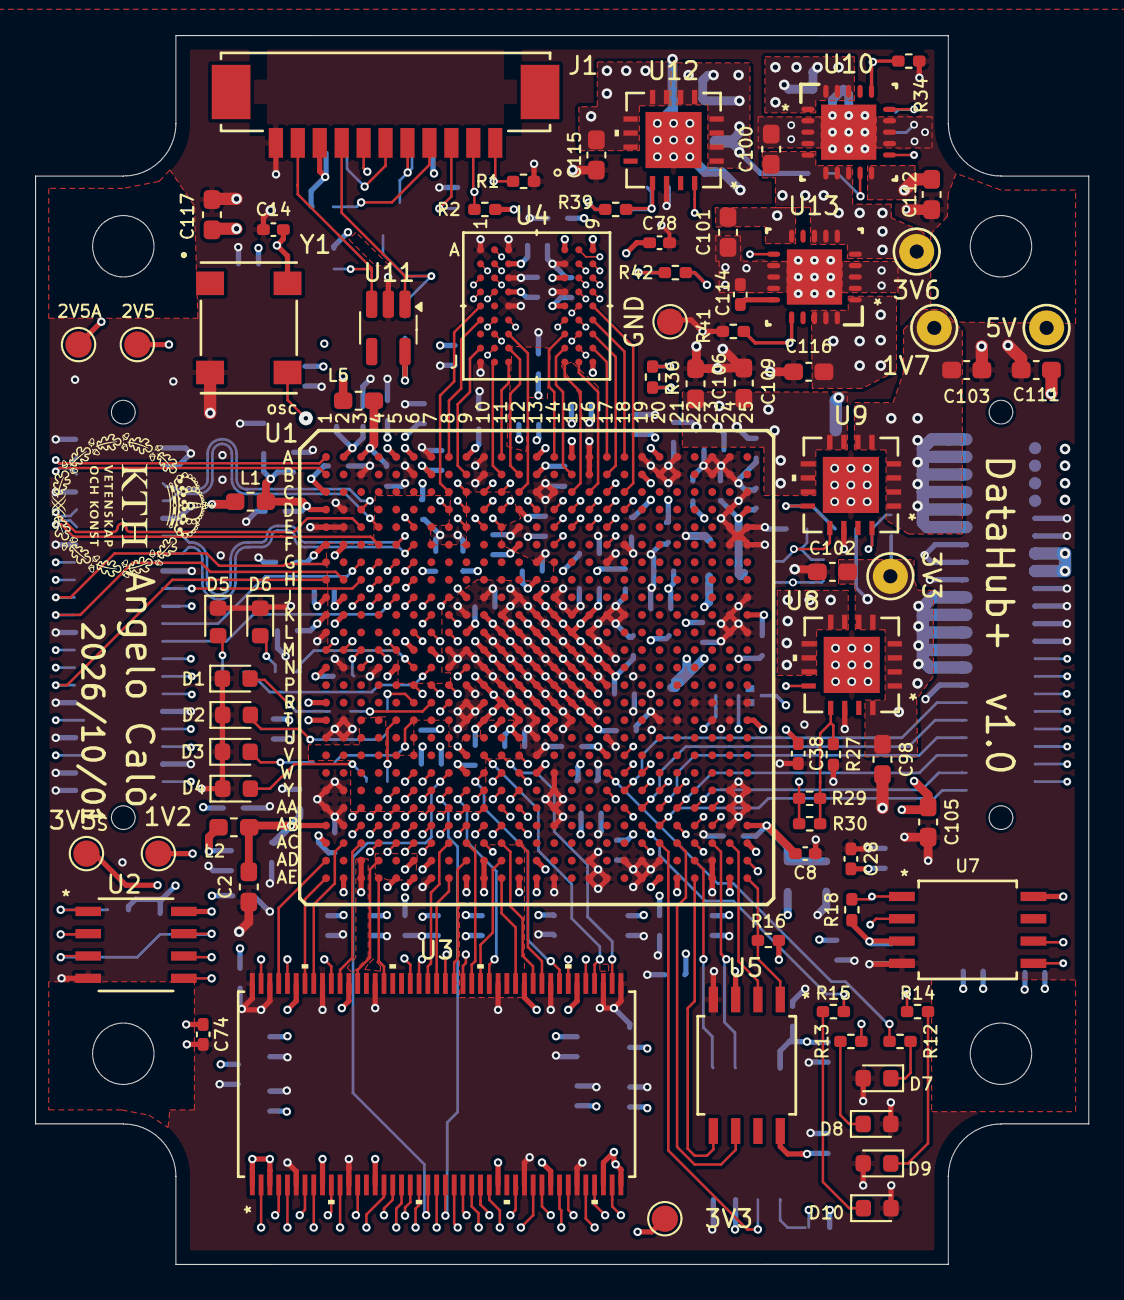
[picture p12: board PCB_Project.kicad_pcb from above]

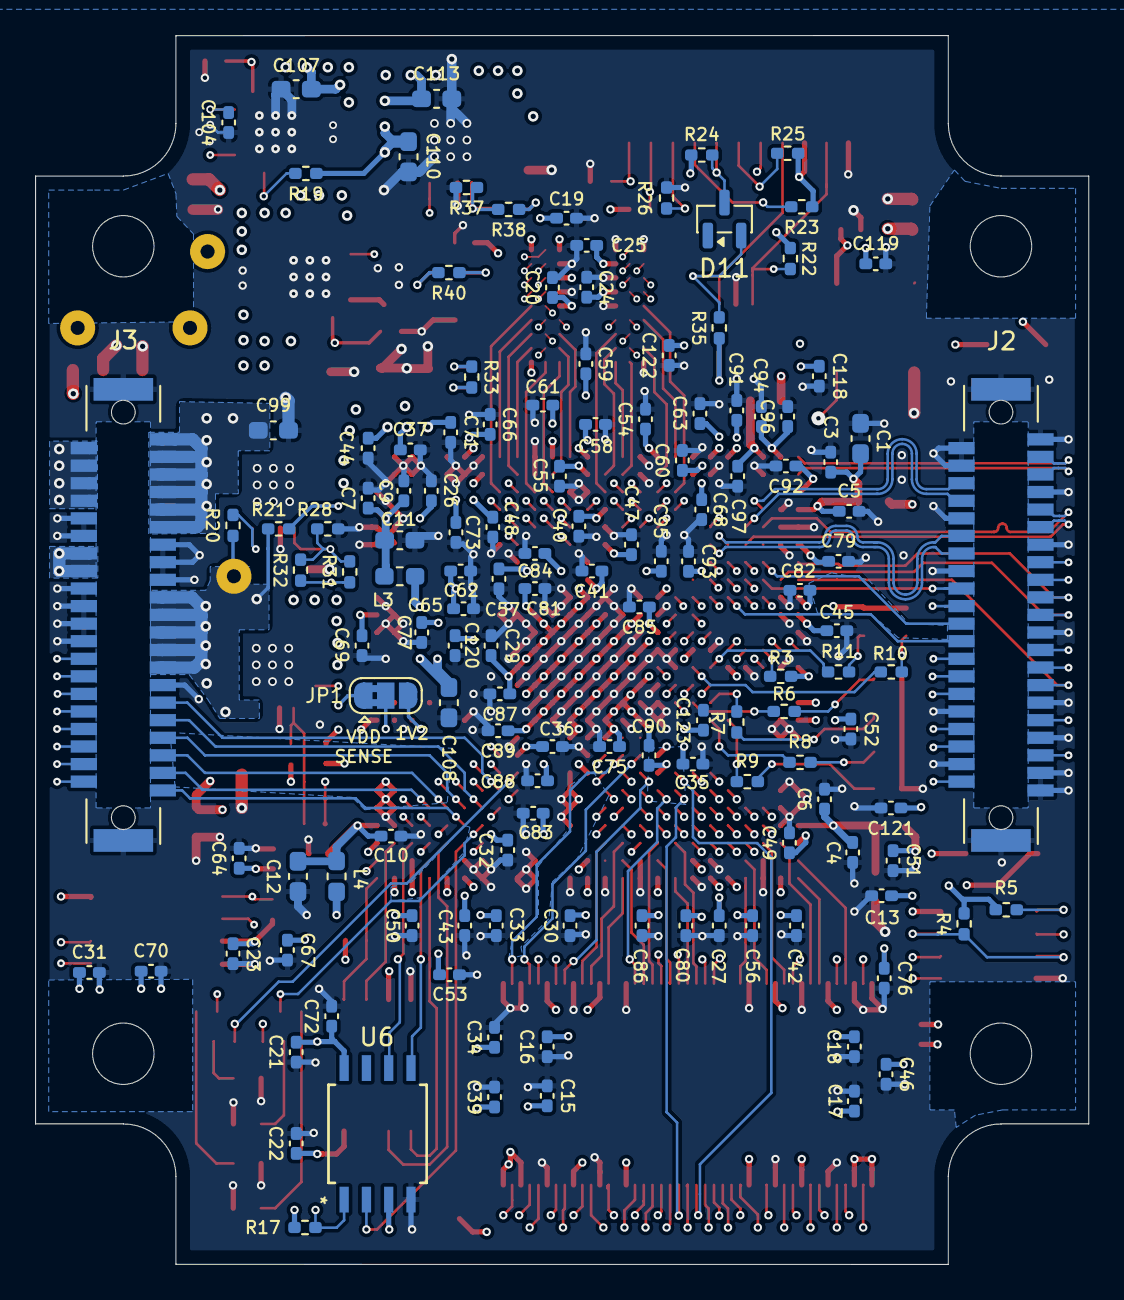
[picture p13: board PCB_Project.kicad_pcb from below]

Board: 8 copper layers, 60.0 x 70.0 mm, 209 parts (135 on the bottom side), 210 nets.
