caloangelo/NG-MEDIUM_NX1H35AS_KiCad_repo/(commit log)

2026-06-23 Project start
    started to take track of changes since major changes will occur in the future.
    [DF9_CFG_SPW1.kicad_sch, IO_Connectors_DF9.kicad_sch, PCB_Project.kicad_pcb, PCB_Project.kicad_sch, Power_rails.kicad_sch, Sheet1.kicad_sch, Sheet2.kicad_sch, Sheet3.kicad_sch]
2026-06-29 first iteration of sdram
    Fanout completed, started tracing towards the chip
    [DF9_CFG_SPW1.kicad_sch, PCB_Project.kicad_pcb, Power_rails.kicad_sch, bank5_SPI.kicad_sch, banks23_SDRAM.kicad_sch, config_reset.kicad_sch, core_cfg.kicad_sch]
2026-06-29 iteration 2 sdram
    finished connections with sdram. shortened and adjusted as much as possible the traces.
    straightened the traces.
    [PCB_Project.kicad_pcb]
2026-06-29 SDRAM iteration 3
    finalized SDRAM connections and placement. optimized space and connectivity.
    TBD:
    iteration 4 will be regarding a reconfiguration of the pinout to try out a more optimal tracing.
    [PCB_Project.kicad_pcb]
2026-07-09 SDRAM, bank5
    last iteration of sdram. max optimization routing and space wise. Traced 2 frams to Bank 5. Fanout of bank 5 for DF9
    [DF9_CFG_SPW1.kicad_sch, IO_Connectors_DF9.kicad_sch, PCB_Project.kicad_pcb, Power_rails.kicad_sch, bank5_SPI.kicad_sch, banks23_SDRAM.kicad_sch, config_reset.kicad_sch, core_cfg.kicad_sch]
2026-07-13 added MAX, picoblade, NPN
    added the LDO (placement), added the picoblade connector for CFG and deleted one SPW out of 2 in the DF9.
    added the NPN transistor (placed)
    [DF9_CFG_SPW1.kicad_sch, PCB_Project.kicad_pcb, PCB_Project.kicad_sch, config_reset.kicad_sch]
2026-07-21 full components, LEDS, changed edges
    all components on pcb editor. added and routed leds and 2 PLL. changed edges o have more space
    [DF9_CFG_SPW1.kicad_sch, IO_Connectors_DF9.kicad_sch, Power_rails.kicad_sch, bank5_SPI.kicad_sch, config_reset.kicad_sch, core_cfg.kicad_sch, debug_uart.kicad_sch, unused.kicad_sch]
2026-07-29 SPW Bank0
    completed SPW, rotated edges and adjusted dimensions to make the extra sdram bga fit. completed Bank 0 (still to route to connector). Started fanout of bga sdram
    [DF9_CFG_SPW1.kicad_sch, IO_Connectors_DF9.kicad_sch, PCB_Project.kicad_pcb, Power_rails.kicad_sch, config_reset.kicad_sch, unused.kicad_sch]
2026-08-01 CFG, bga sdram, banks to connectors, docoupling
    Finished completely routing bga sdram, finished tracing Banks to connectors DF9. Finished tracing Picoblade, diode, reset supervisor. Finished tracing LEDS on bank 5. Finished decoupling all banks and core. Missing only the power tree and power rail level decoupling.
    [DF9_CFG_SPW1.kicad_sch, IO_Connectors_DF9.kicad_sch, PCB_Project.kicad_pcb, PCB_Project.kicad_sch, Power_rails.kicad_sch, bank5_SPI.kicad_sch, config_reset.kicad_sch, core_cfg.kicad_sch]
2026-09-02 power tree
    power tree defined. Few changes remaining but almost finalized
    [DF9_CFG_SPW1.kicad_sch, IO_Connectors_DF9.kicad_sch, PCB_Project.kicad_pcb, PCB_Project.kicad_sch, Power_rails.kicad_sch, bank5_SPI.kicad_sch, config_reset.kicad_sch, core_cfg.kicad_sch]
2026-09-05 finished PCB
    finished power tree and power planes. Completed silkscreen placement. Added test points
    [PCB_Project.kicad_pcb, Power_rails.kicad_sch, unused.kicad_sch]
2026-09-07 finished
    power planes, decoupling, ERC, DRC
    [DF9_CFG_SPW1.kicad_sch, IO_Connectors_DF9.kicad_sch, Power_rails.kicad_sch, bank5_SPI.kicad_sch, banks23_SDRAM.kicad_sch, config_reset.kicad_sch, core_cfg.kicad_sch, debug_uart.kicad_sch]
2026-09-07 connectors df9 distance adjusted
    [PCB_Project.kicad_pcb]
2026-09-24 pre-order adjustments
    DF9 connectors footprint adjusted.
    Dimensions of board edges changed.
    Placement of DF9 adjusted.
    [DF9_CFG_SPW1.kicad_sch, IO_Connectors_DF9.kicad_sch, Power_rails.kicad_sch, bank5_SPI.kicad_sch, banks23_SDRAM.kicad_sch, config_reset.kicad_sch, core_cfg.kicad_sch, debug_uart.kicad_sch]
2026-10-06 pre order adjustments. Board symmetry
    adjusted little things brought up by DFM checker of JLCPCB. Board's edges fully symmetrical on y axis. 2mm shift on x axis of the DF9s maintained
    [DF9_CFG_SPW1.kicad_sch, IO_Connectors_DF9.kicad_sch, PCB_Project.kicad_pcb, PCB_Project.kicad_sch, Power_rails.kicad_sch, bank5_SPI.kicad_sch, banks23_SDRAM.kicad_sch, config_reset.kicad_sch]
2026-10-06 added extra decoupling capacitors
    extra decoupling on 2V5IO and Service rails
    [IO_Connectors_DF9.kicad_sch, PCB_Project.kicad_pcb, Power_rails.kicad_sch, banks23_SDRAM.kicad_sch]
2026-10-07 pre order checks
    ADDED jumper for VDDSENSE remote sensing / 1V2 core PWR for MAX LDO feedback
    [Connectors_DF9_PicoB.kicad_sch, Decoupling_Network.kicad_sch, FPGA_Bank0_1.kicad_sch, FPGA_Banks11_12_CFG_Service.kicad_sch, FPGA_Banks2_3_SDRAM.kicad_sch, FPGA_Banks4_5_SPI.kicad_sch, FPGA_Banks9_10_SDRAM_bga.kicad_sch, FPGA_Core_PLL.kicad_sch]
